180337/LCR-Analyzer-WebSite-ZXY/docs/show/html-to-ppt/assets/hw/ui-menu.jpg

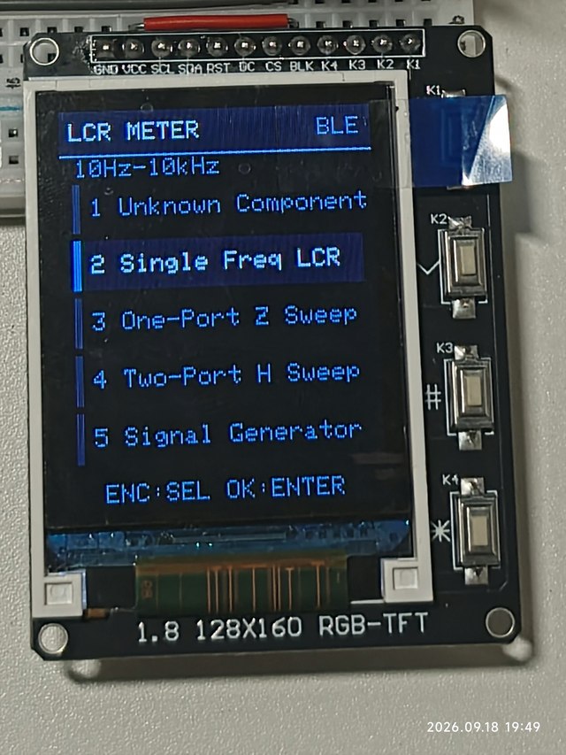
docs/show/html-to-ppt/assets/hw/ui-menu.jpg
