180337/LCR-Analyzer-WebSite-ZXY/docs/show/html-to-ppt/01-张行言-2025010170-硬设PPTv1.0.pptx

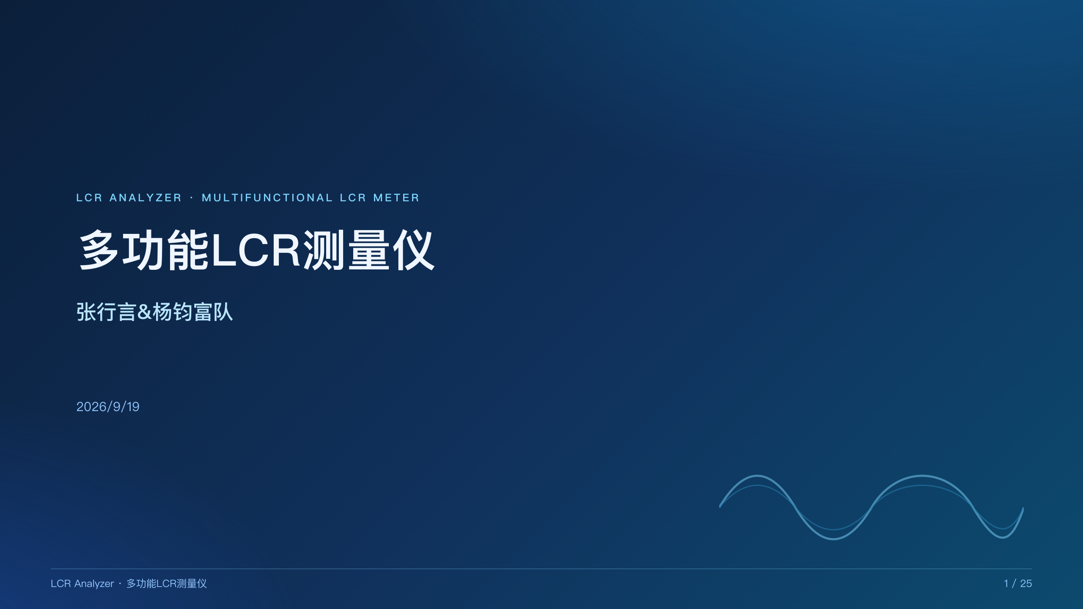
[picture p3: figure]

## Slide 2

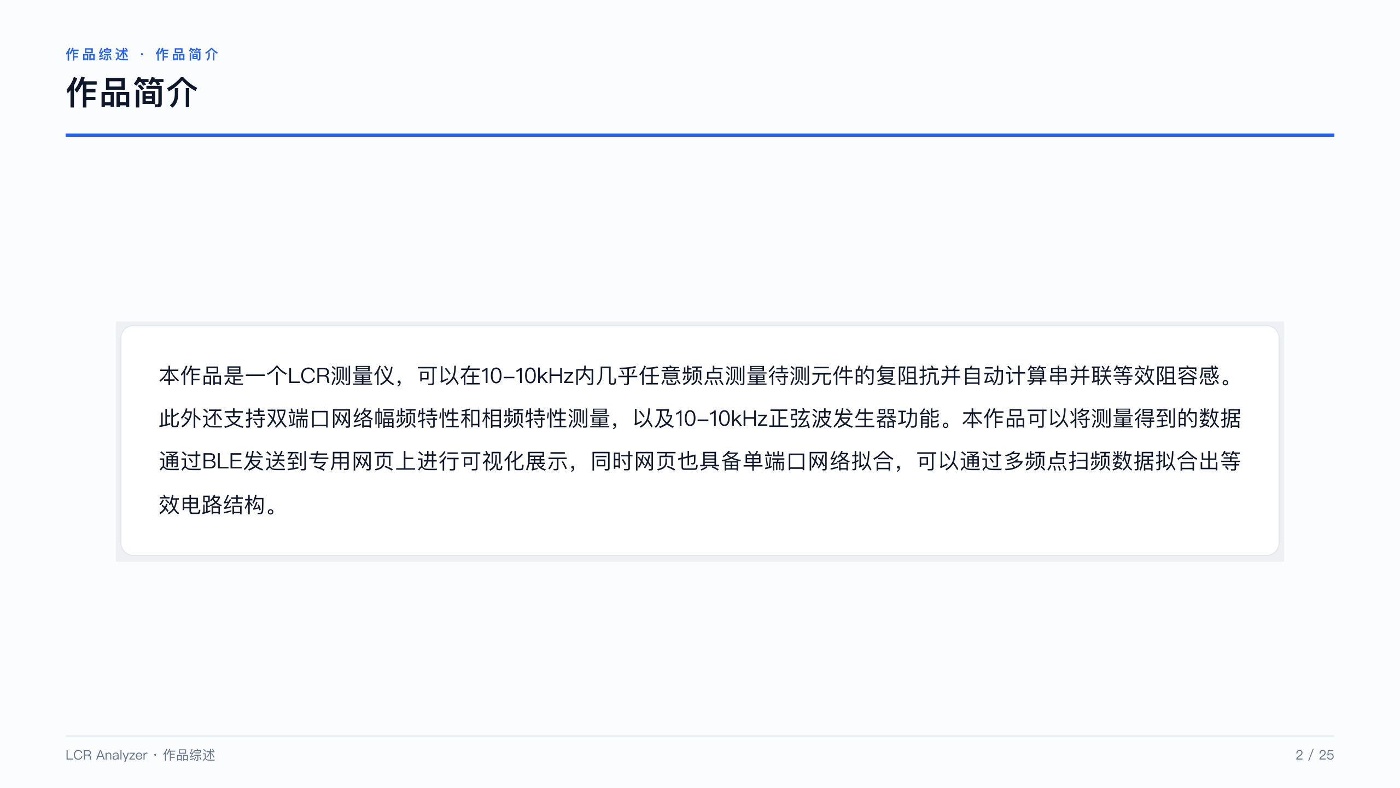
[picture p4: figure]

## Slide 3

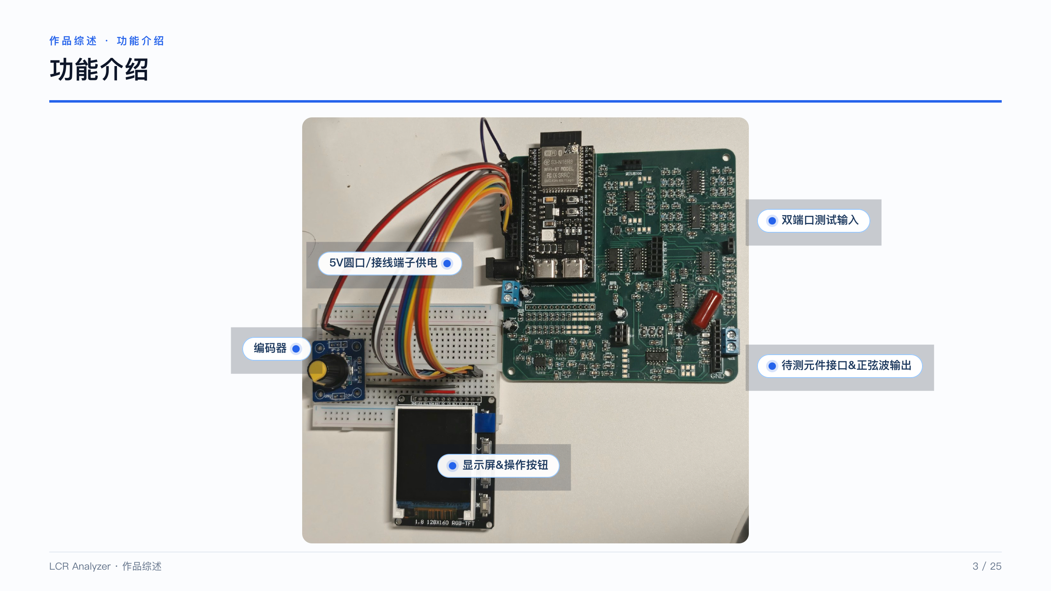
[picture p5: figure]

## Slide 4

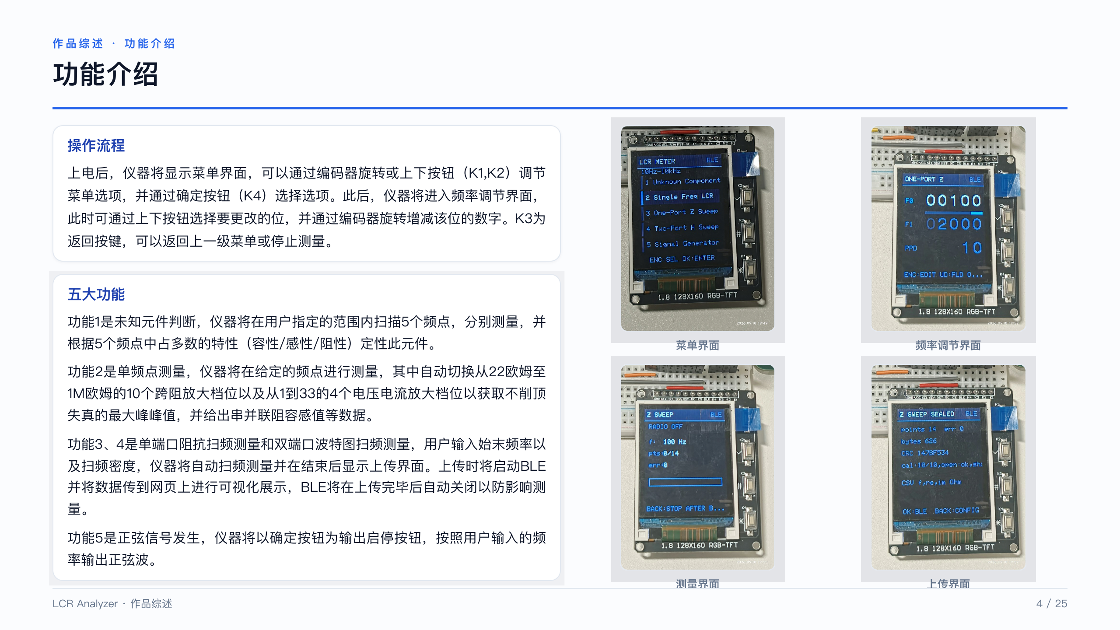
[picture p6: figure]

## Slide 5

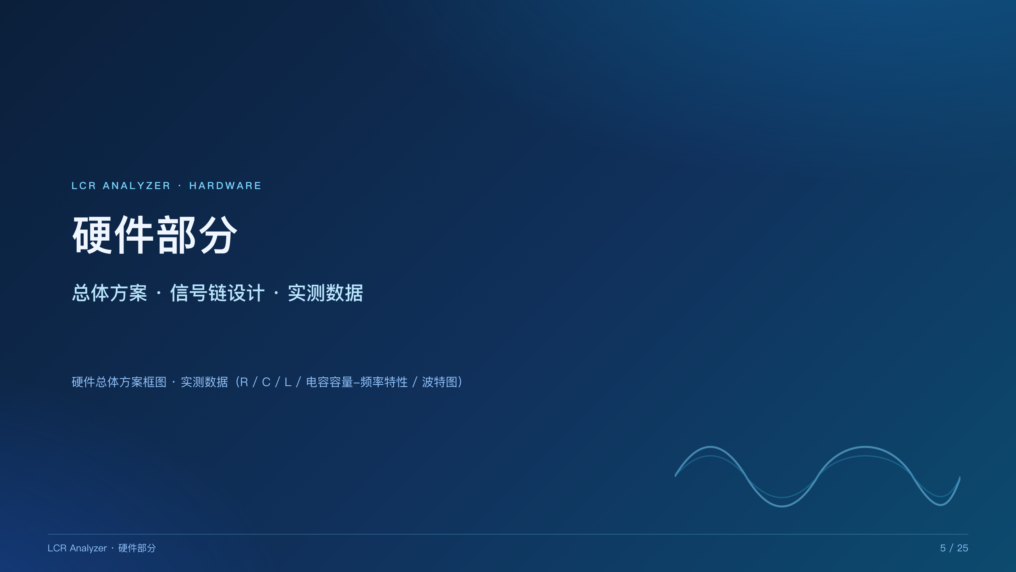
[picture p7: figure]

## Slide 6

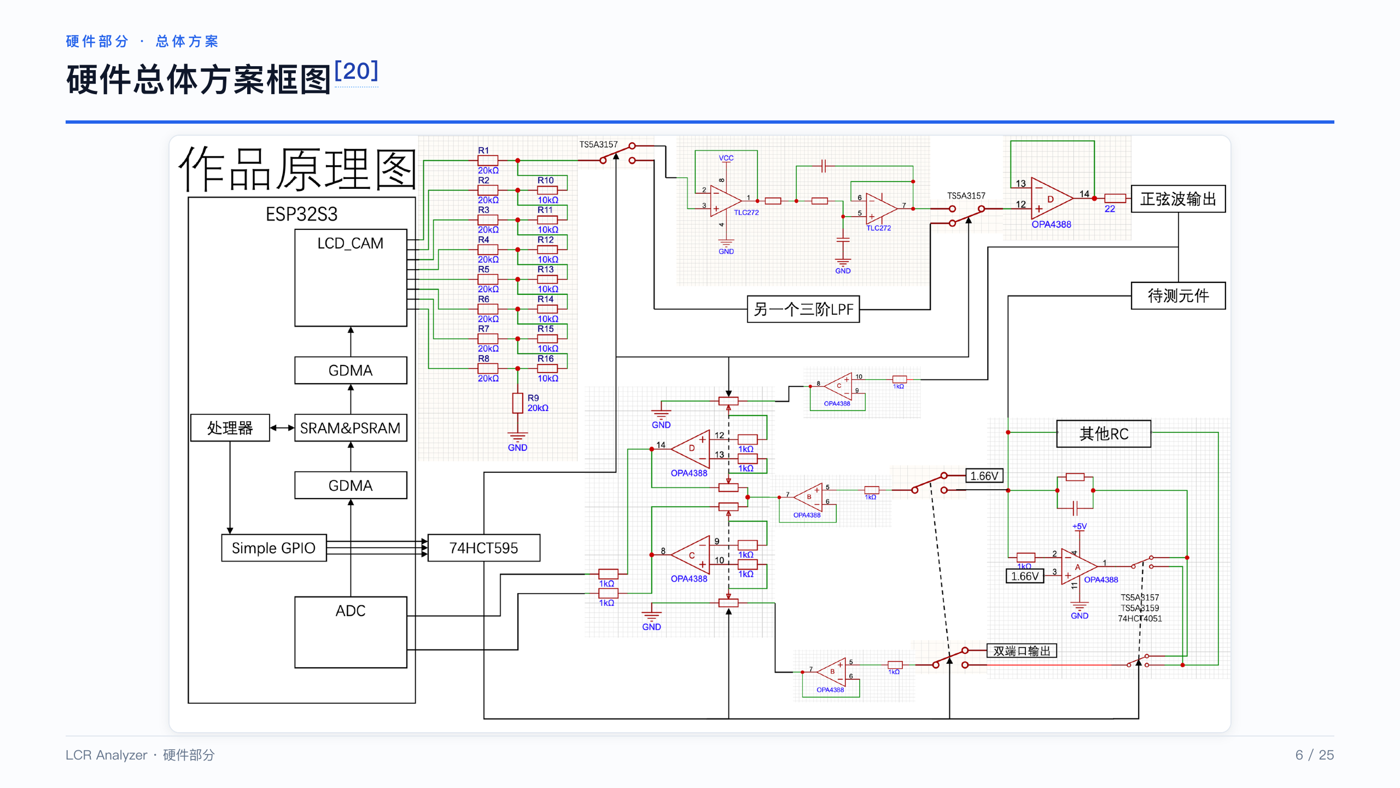
[picture p8: figure]

## Slide 7

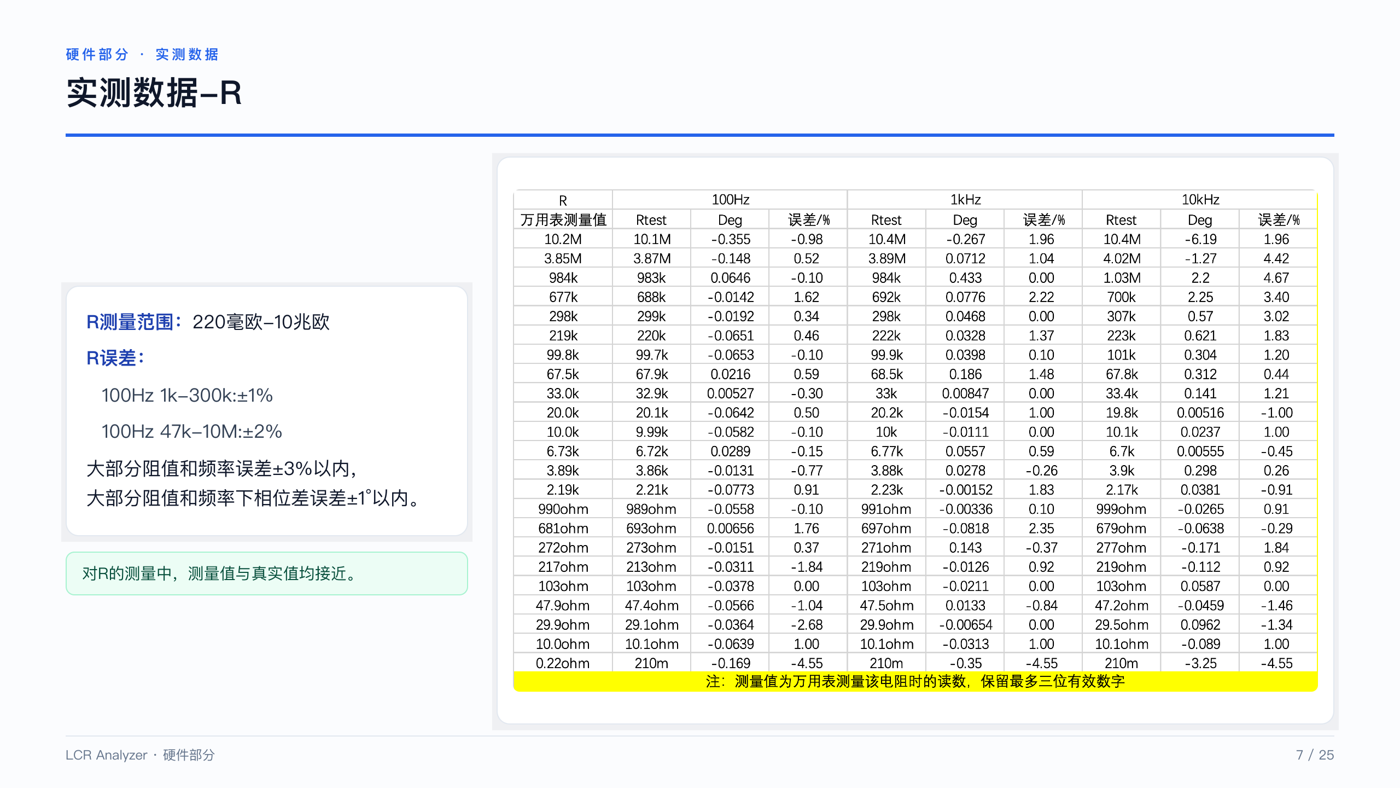
[picture p9: figure]

## Slide 8

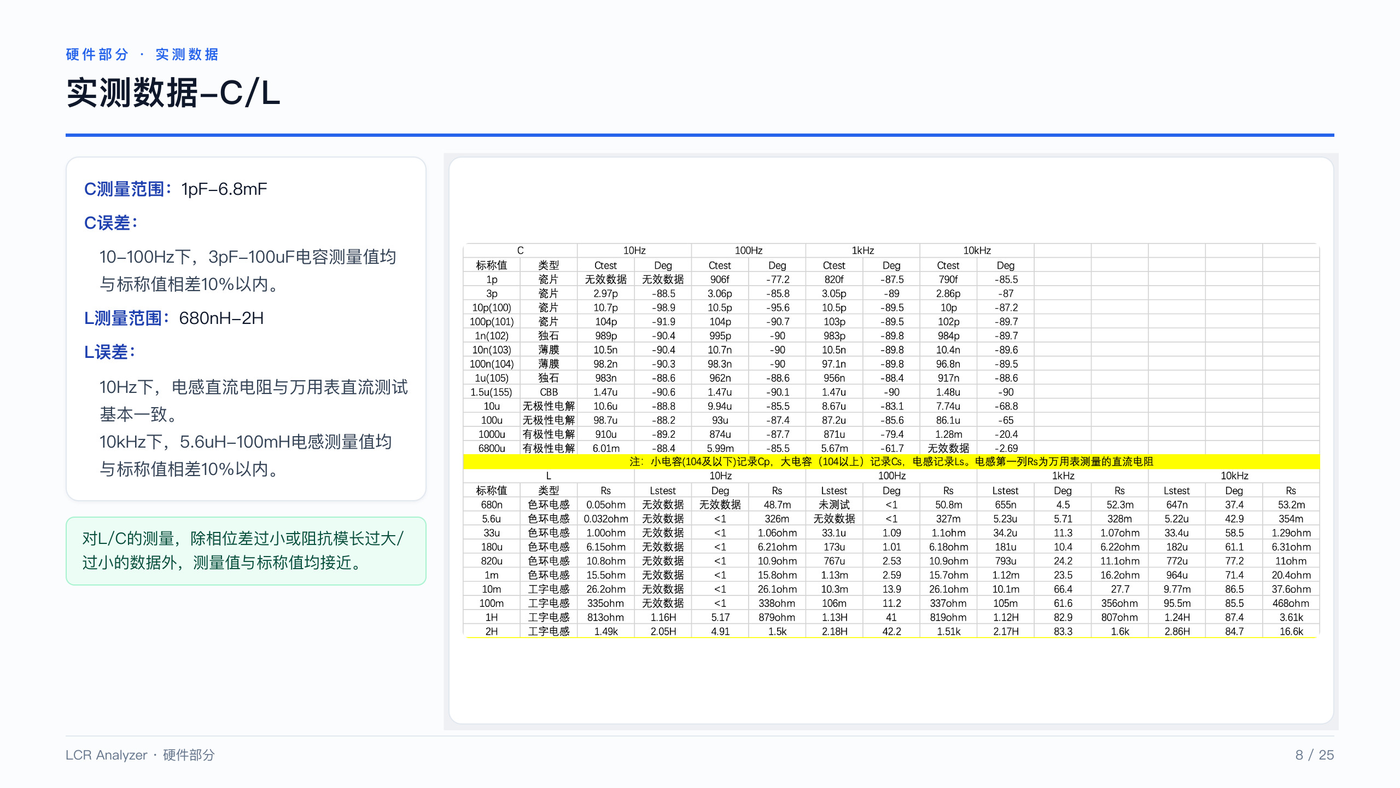
[picture p10: figure]

## Slide 9

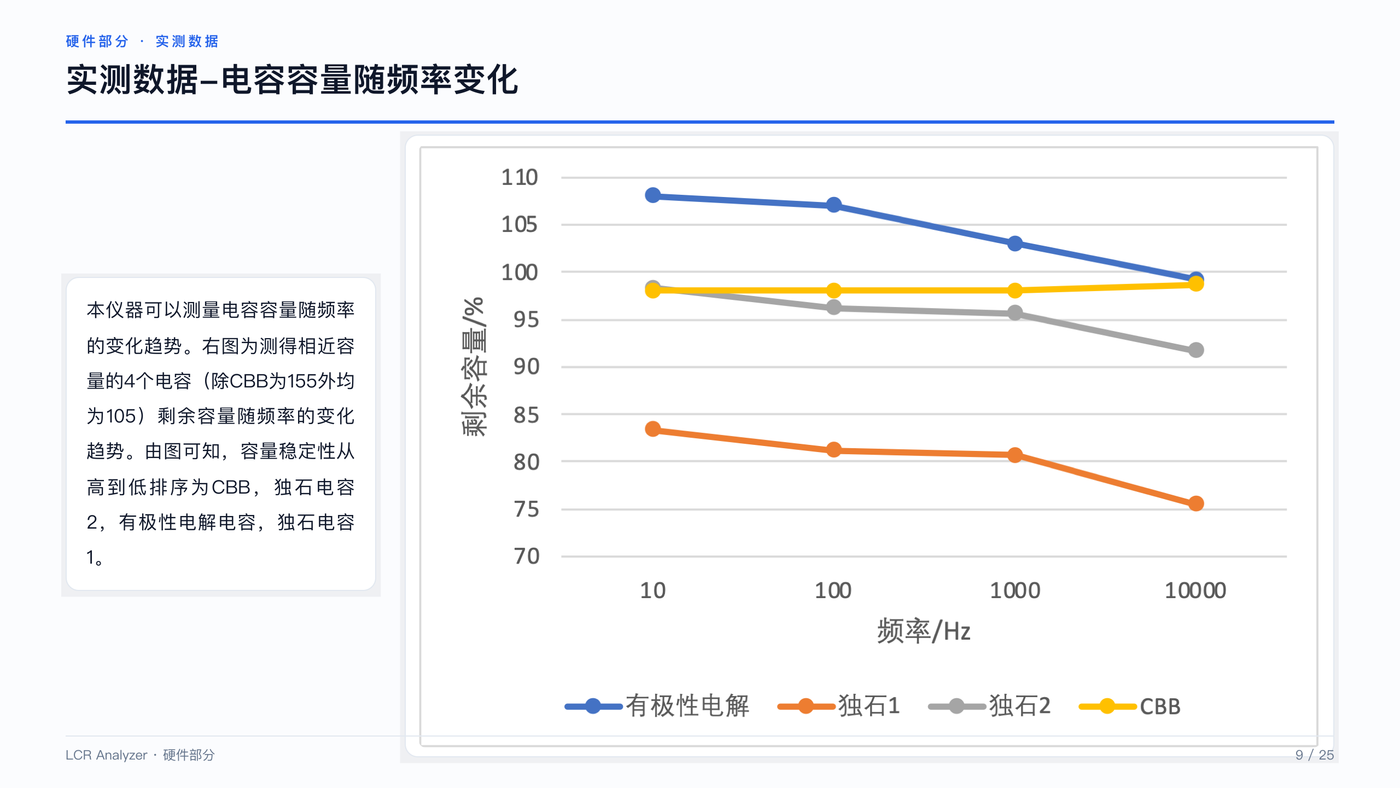
[picture p11: figure]

## Slide 10

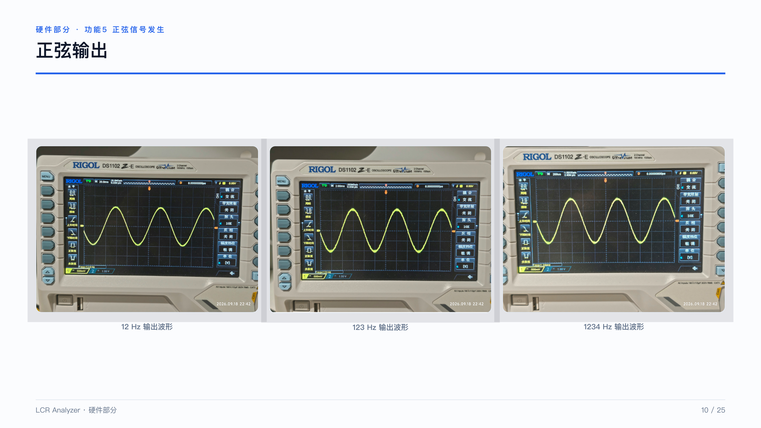
[picture p12: figure]

## Slide 11

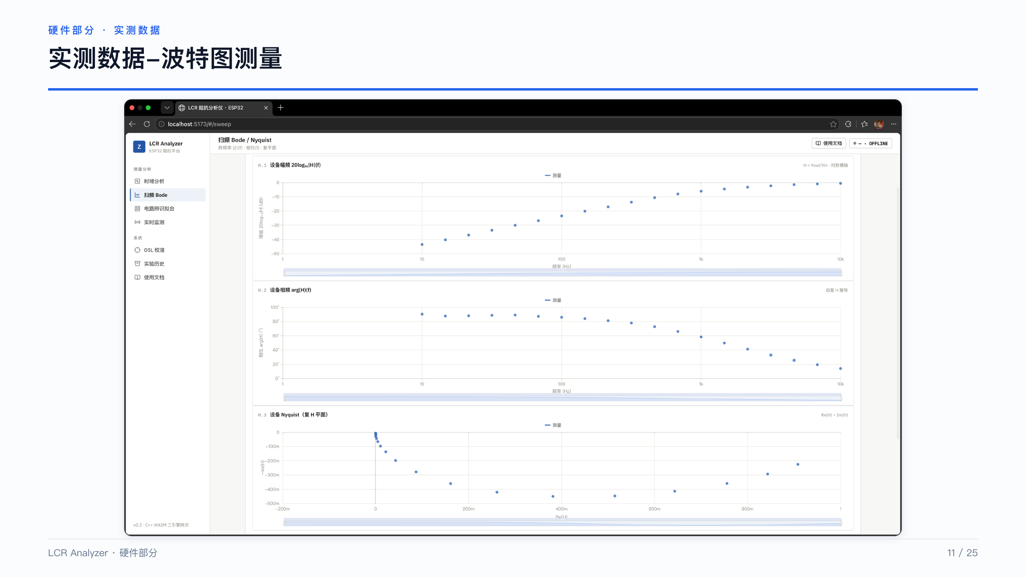
[picture p13: figure]

## Slide 12

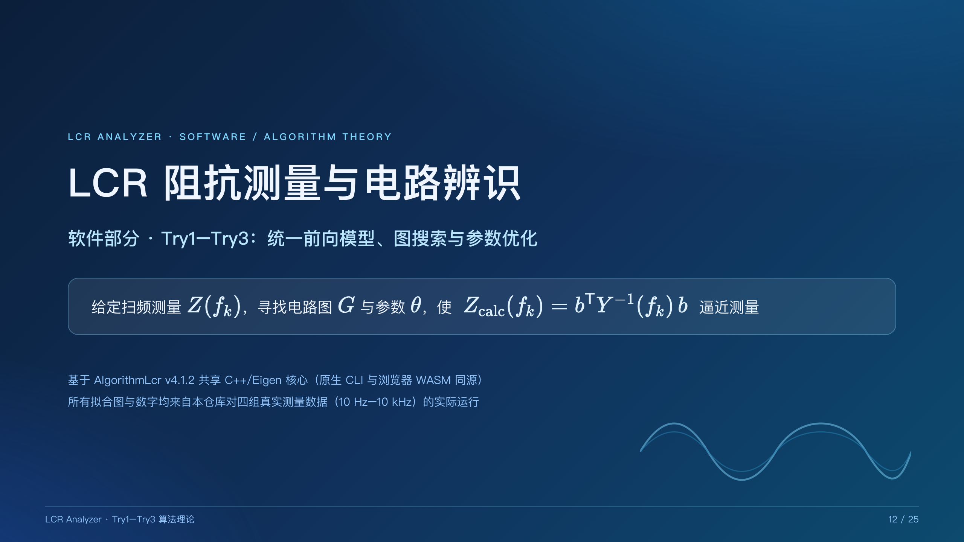
[picture p14: figure]

## Slide 13

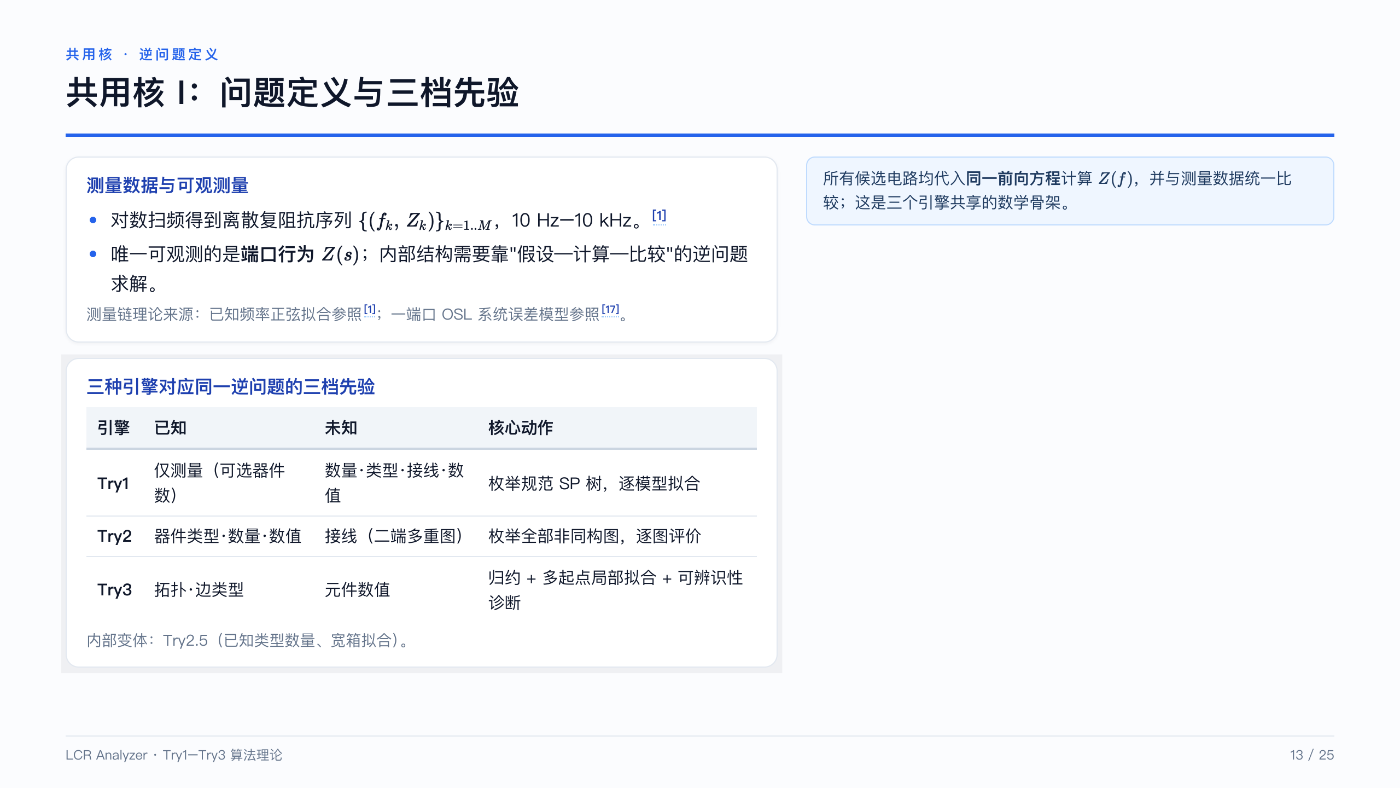
[picture p15: figure]

## Slide 14

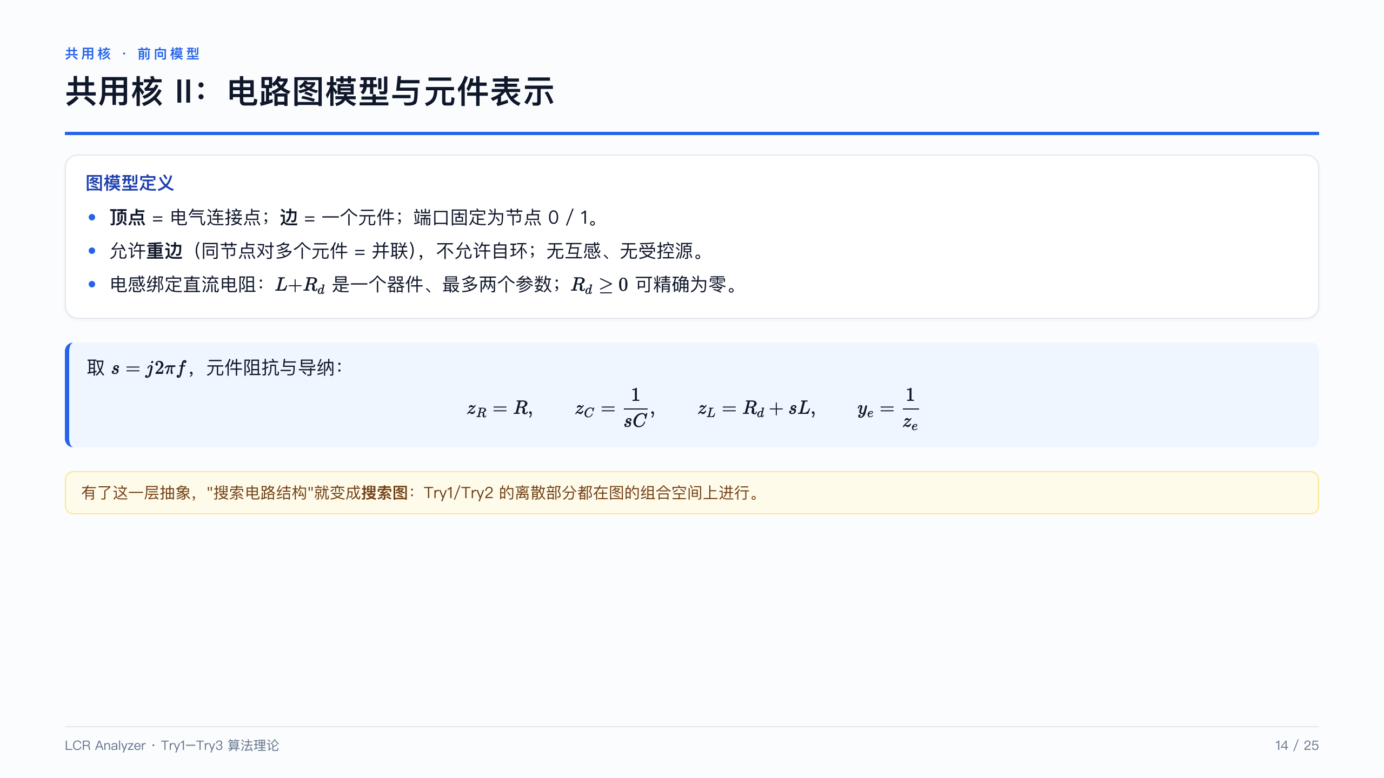
[picture p16: figure]

## Slide 15

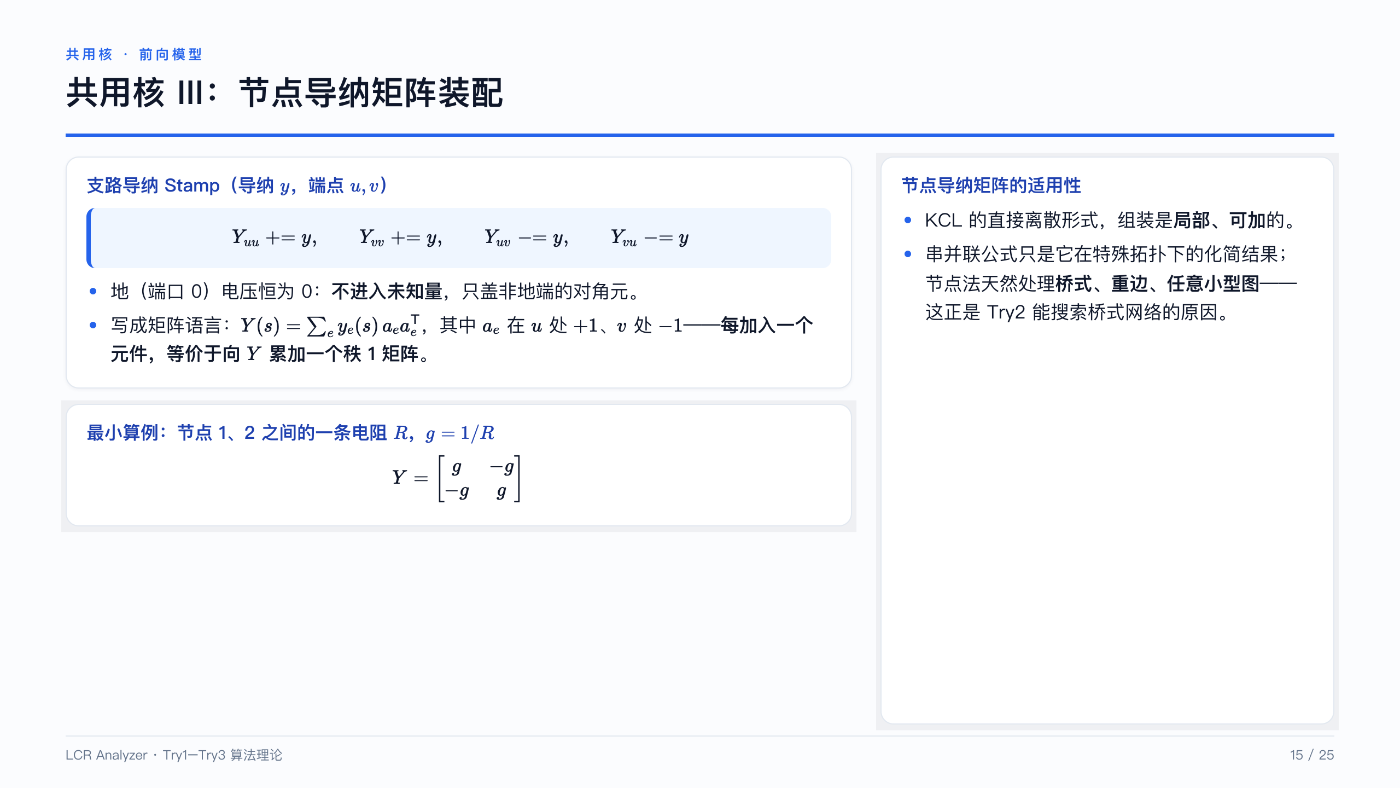
[picture p17: figure]

## Slide 16

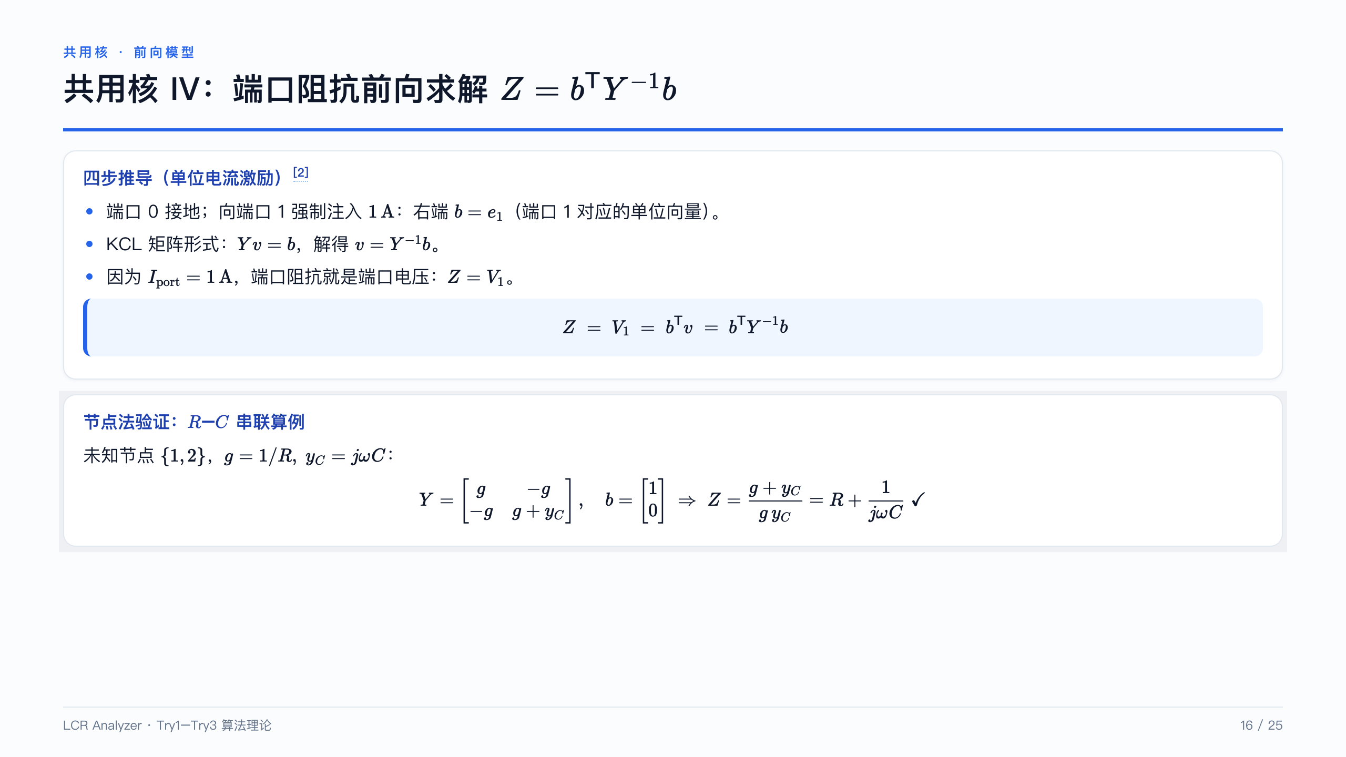
[picture p18: figure]

## Slide 17

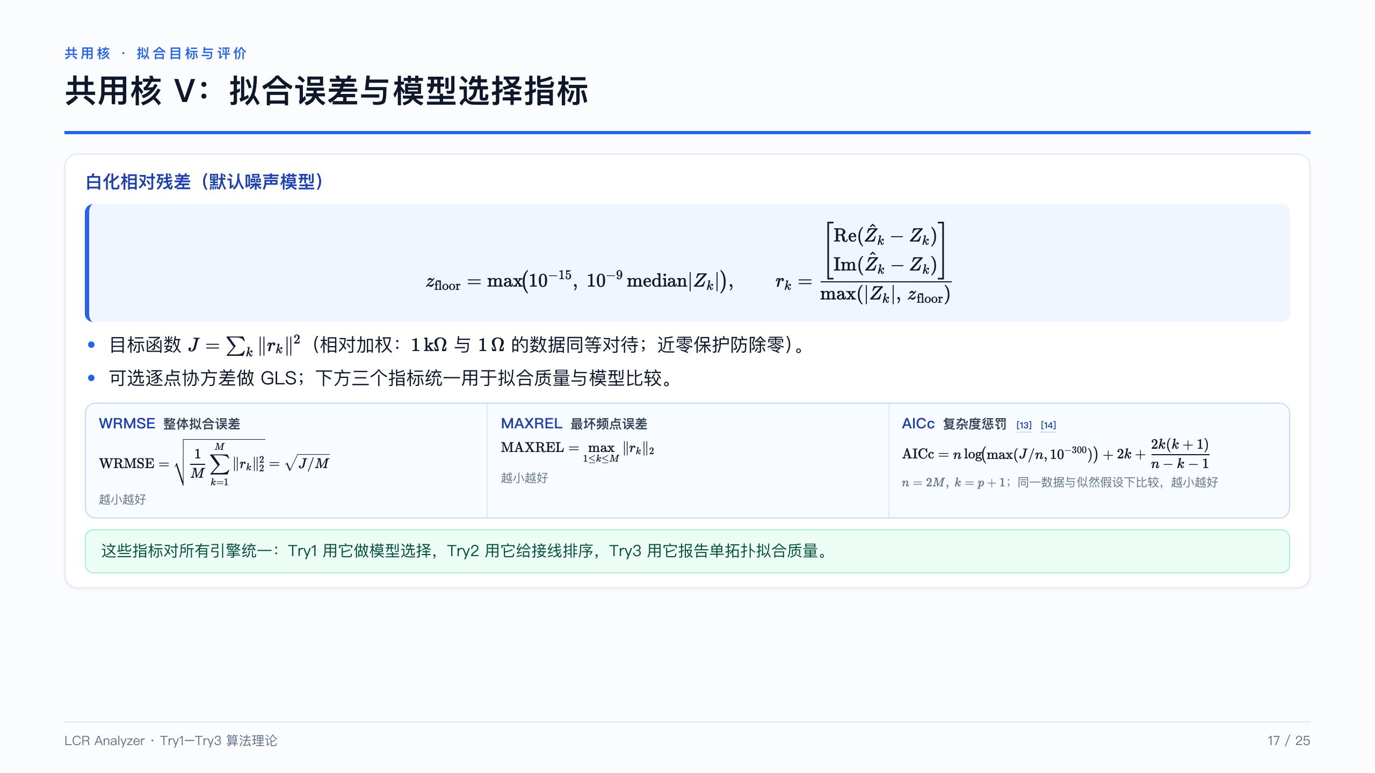
[picture p19: figure]

## Slide 18

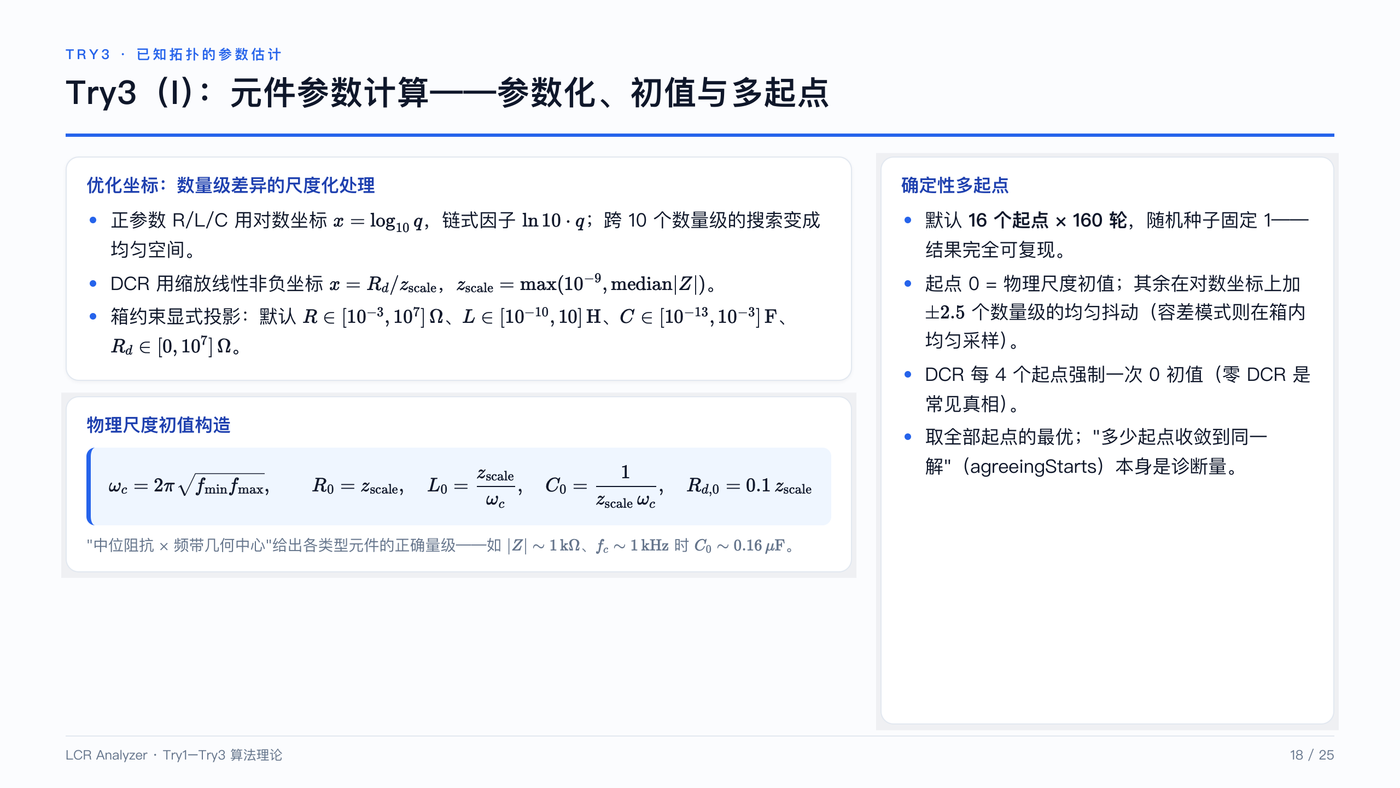
[picture p20: figure]

## Slide 19

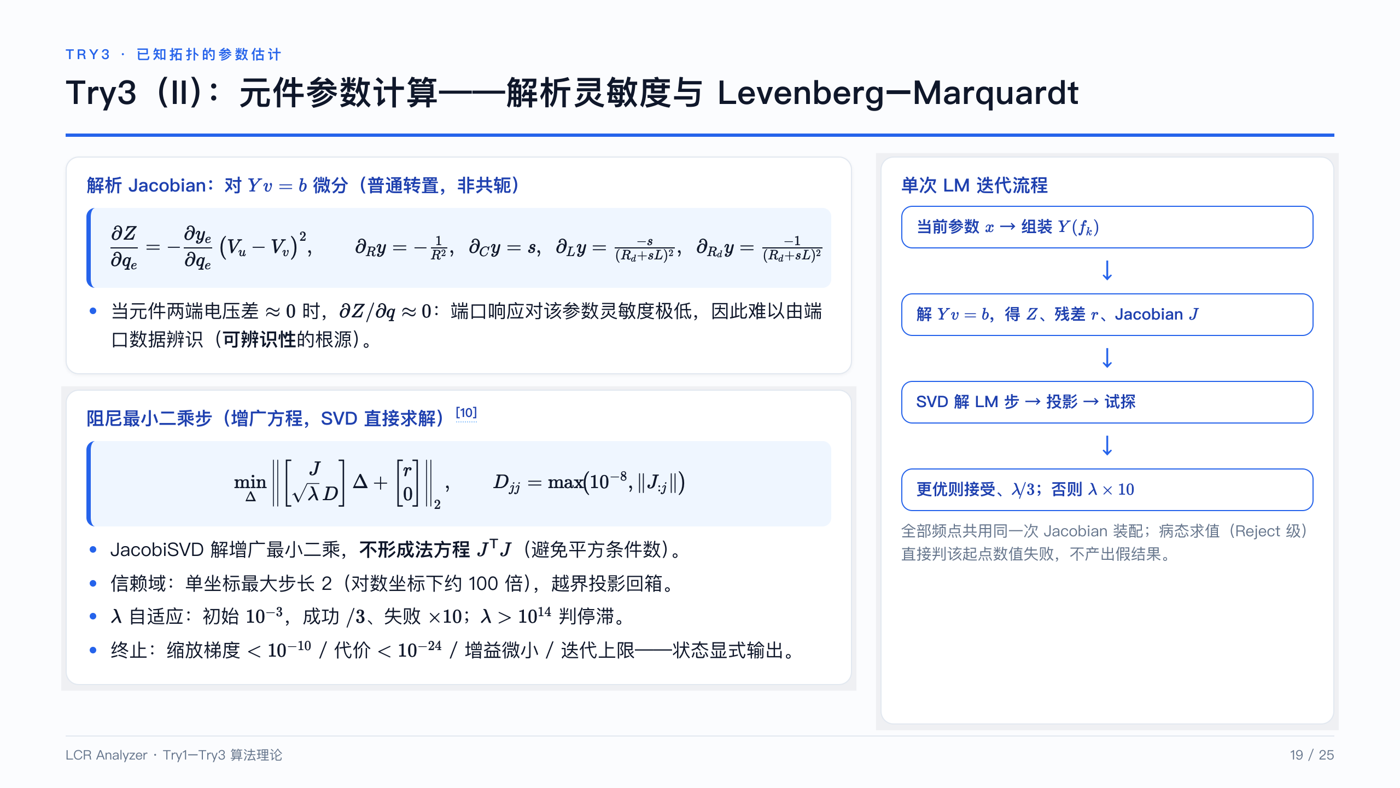
[picture p21: figure]

## Slide 20

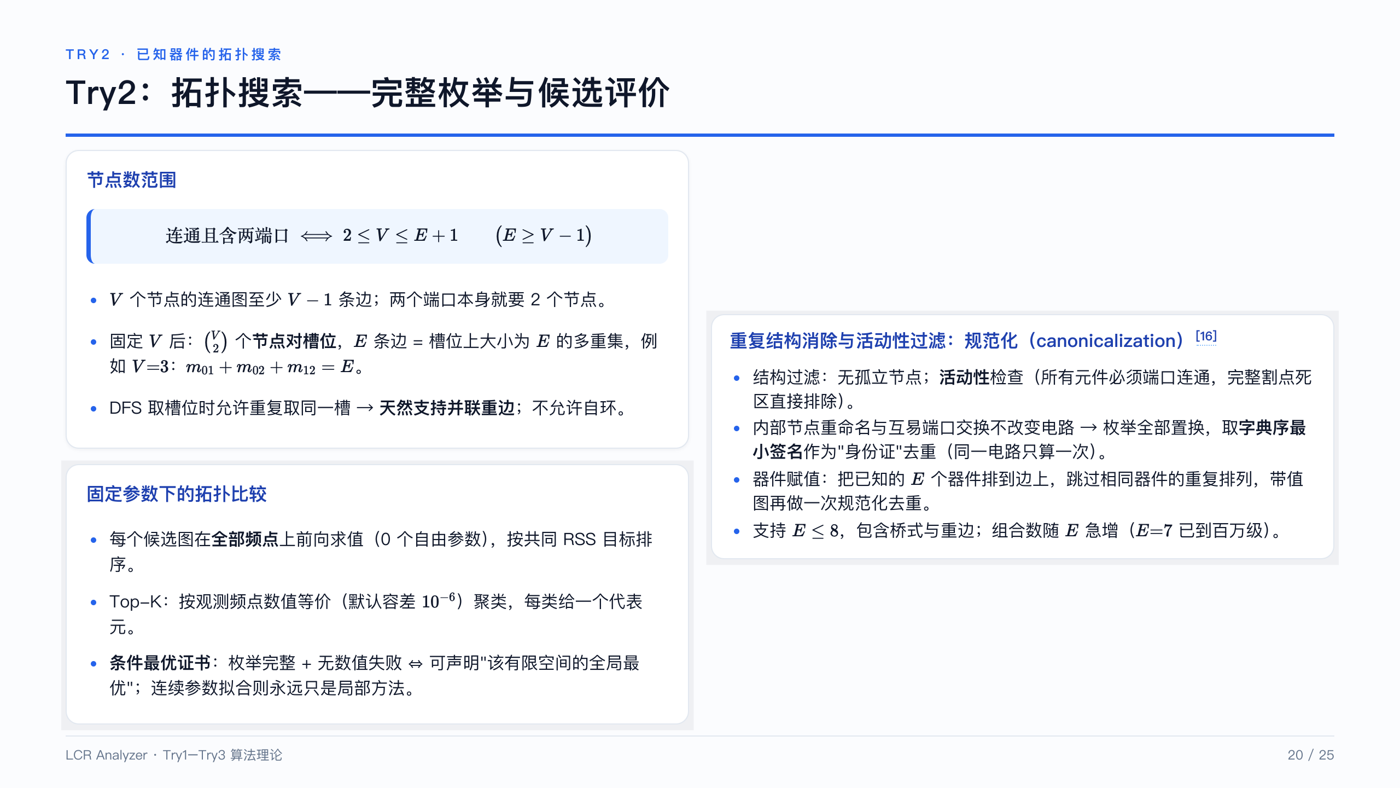
[picture p22: figure]

## Slide 21

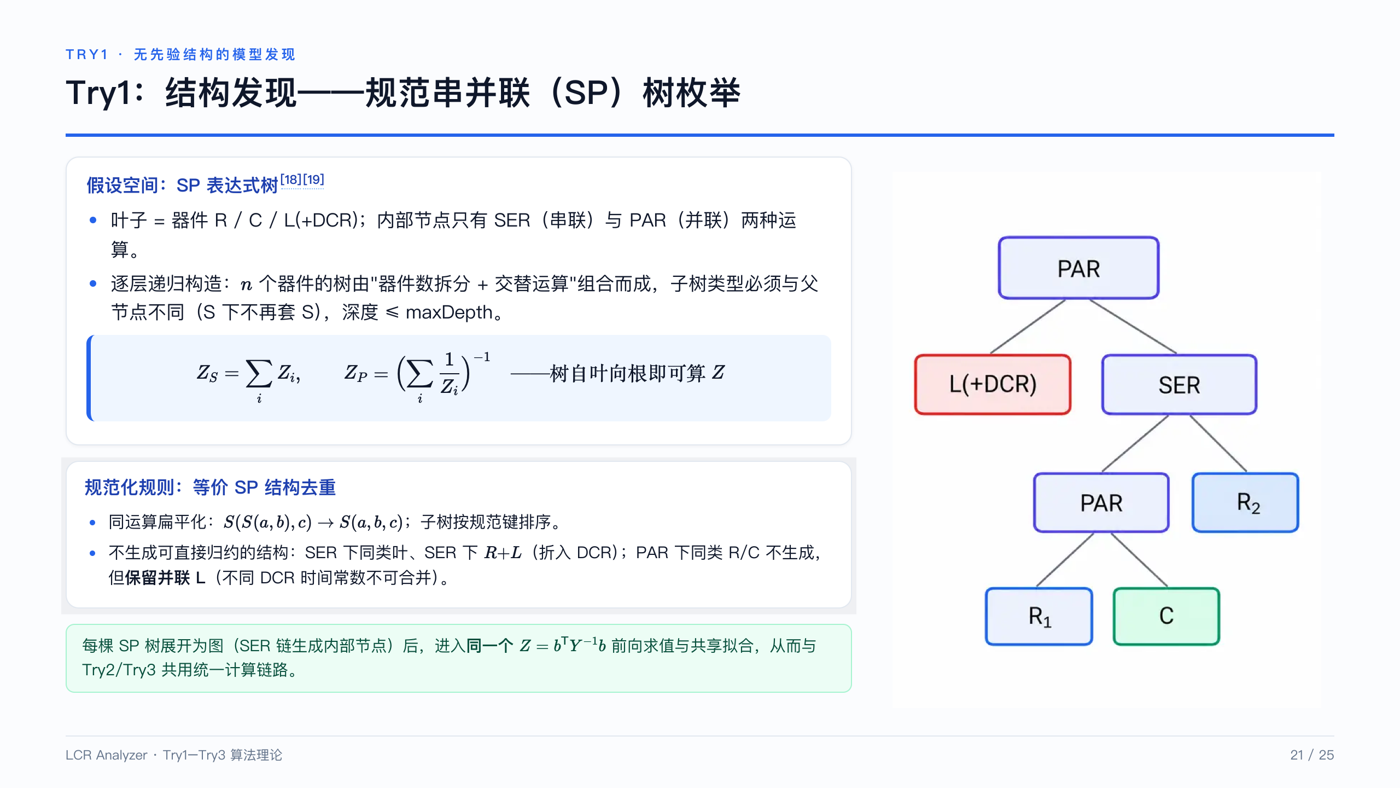
[picture p23: figure]

## Slide 22

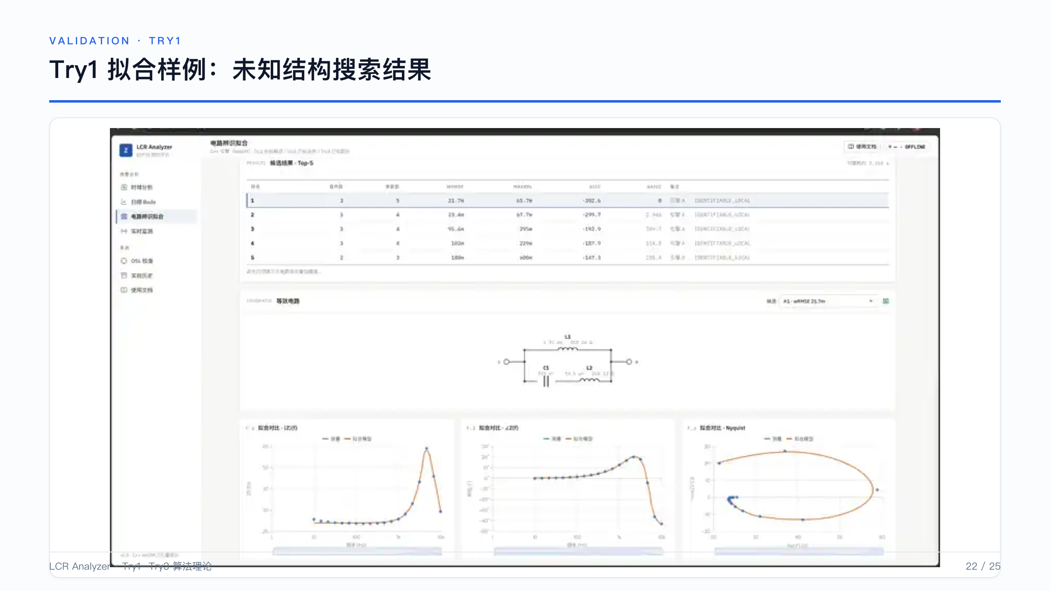
[picture p24: figure]

## Slide 23

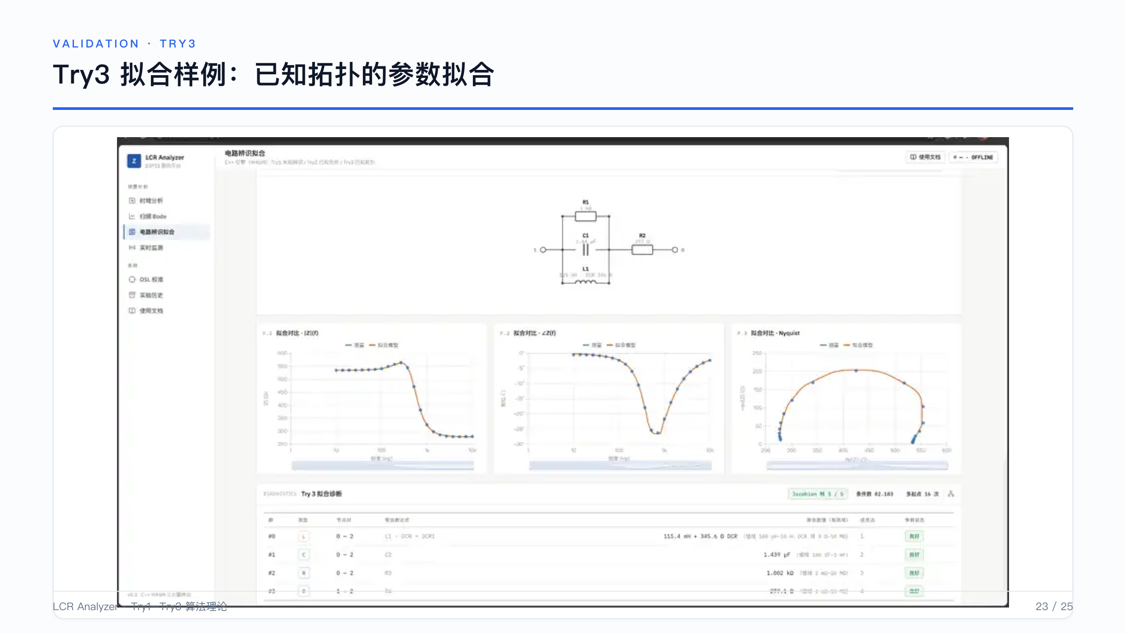
[picture p25: figure]

## Slide 24

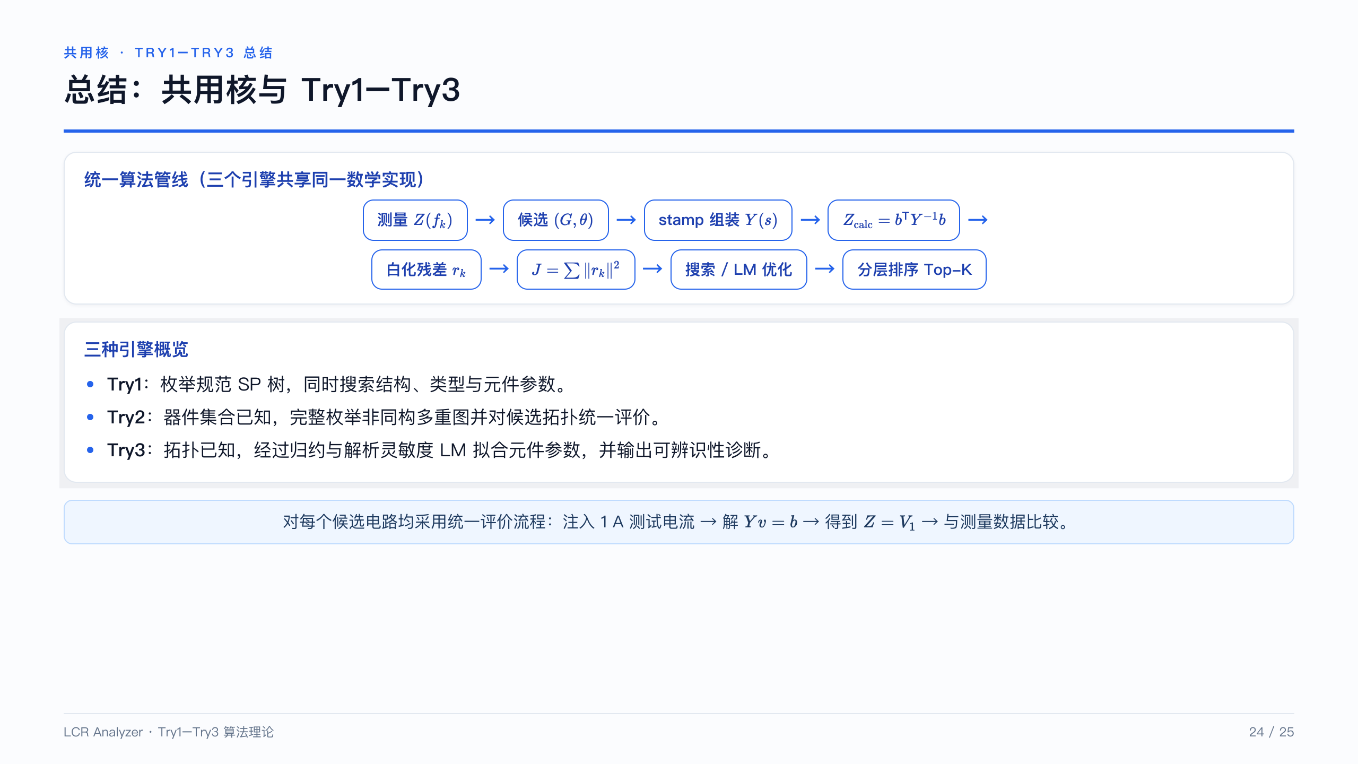
[picture p26: figure]

## Slide 25

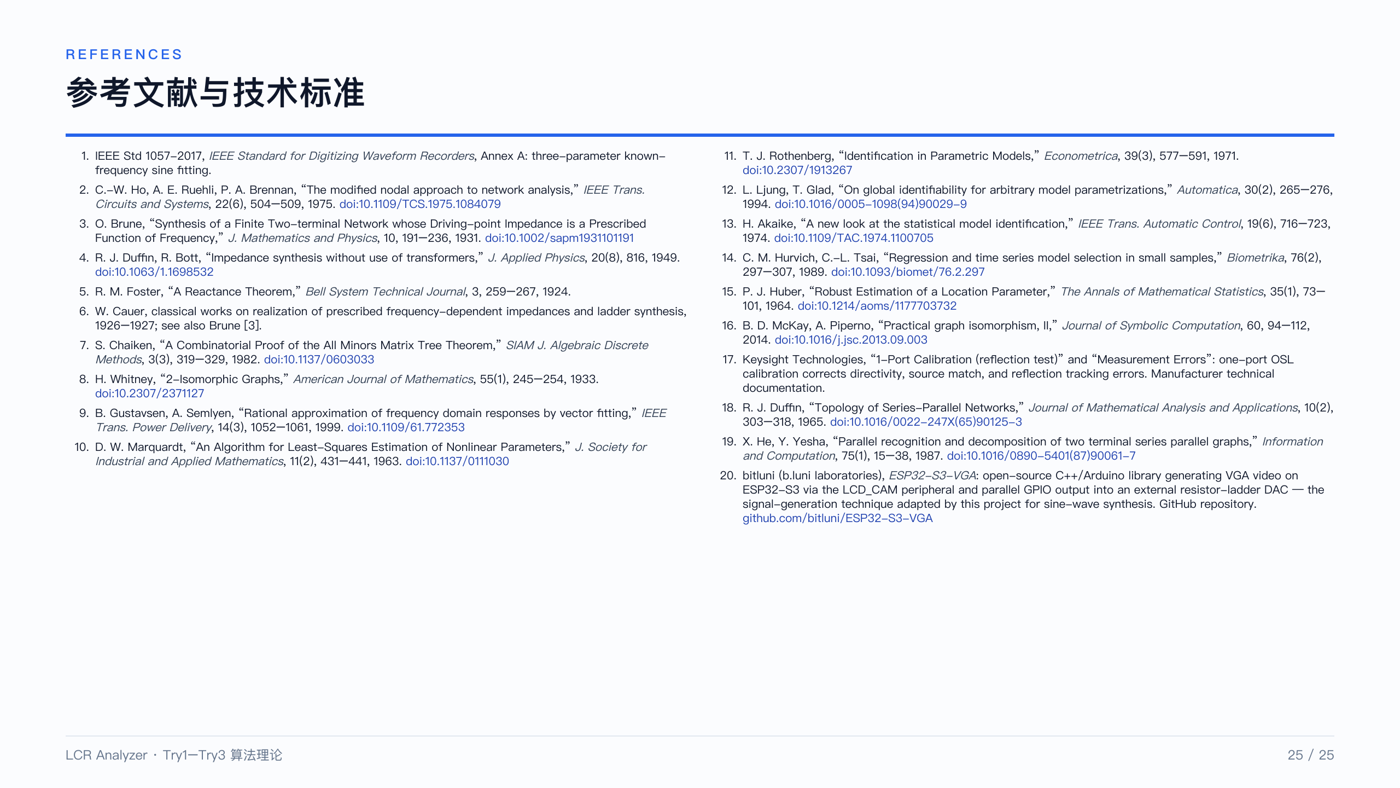
[picture p27: figure]
