180337/LCR-Analyzer-WebSite-ZXY/docs/show/html-to-ppt/assets/figs/fig-funnel.png

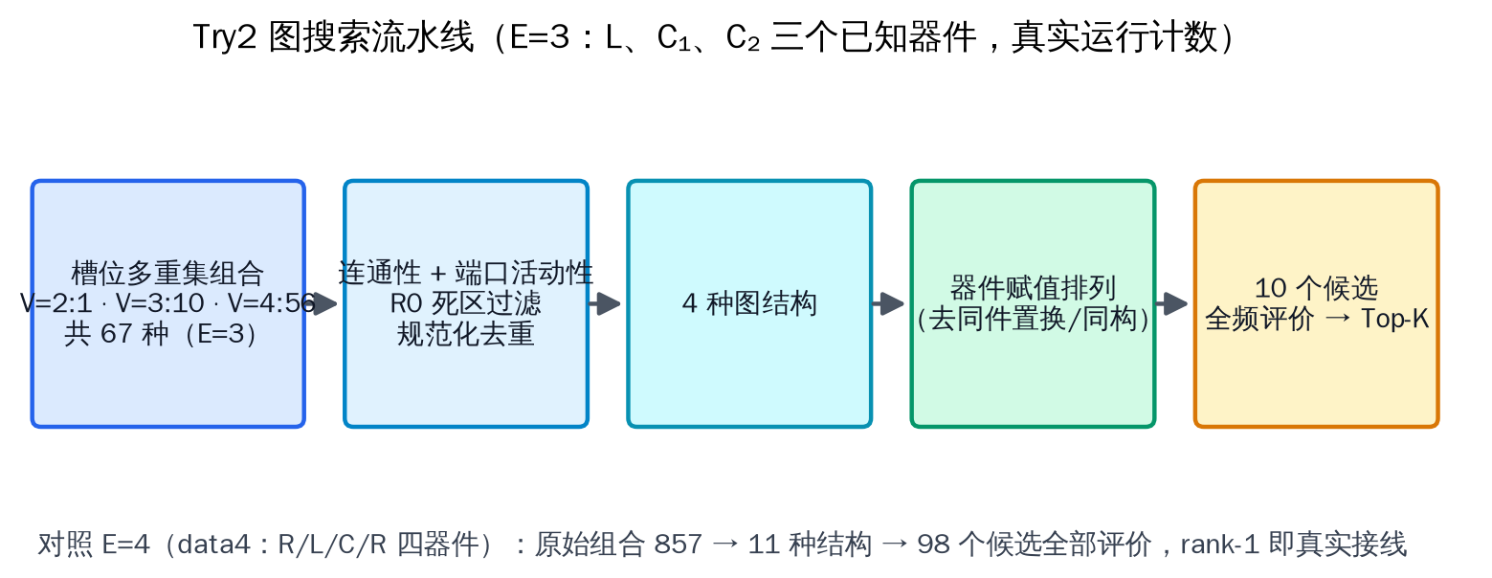
docs/show/html-to-ppt/assets/figs/fig-funnel.png
