180337/LCR-Analyzer-WebSite-ZXY/docs/show/html-to-ppt/assets/figs/try1-data2-2.png

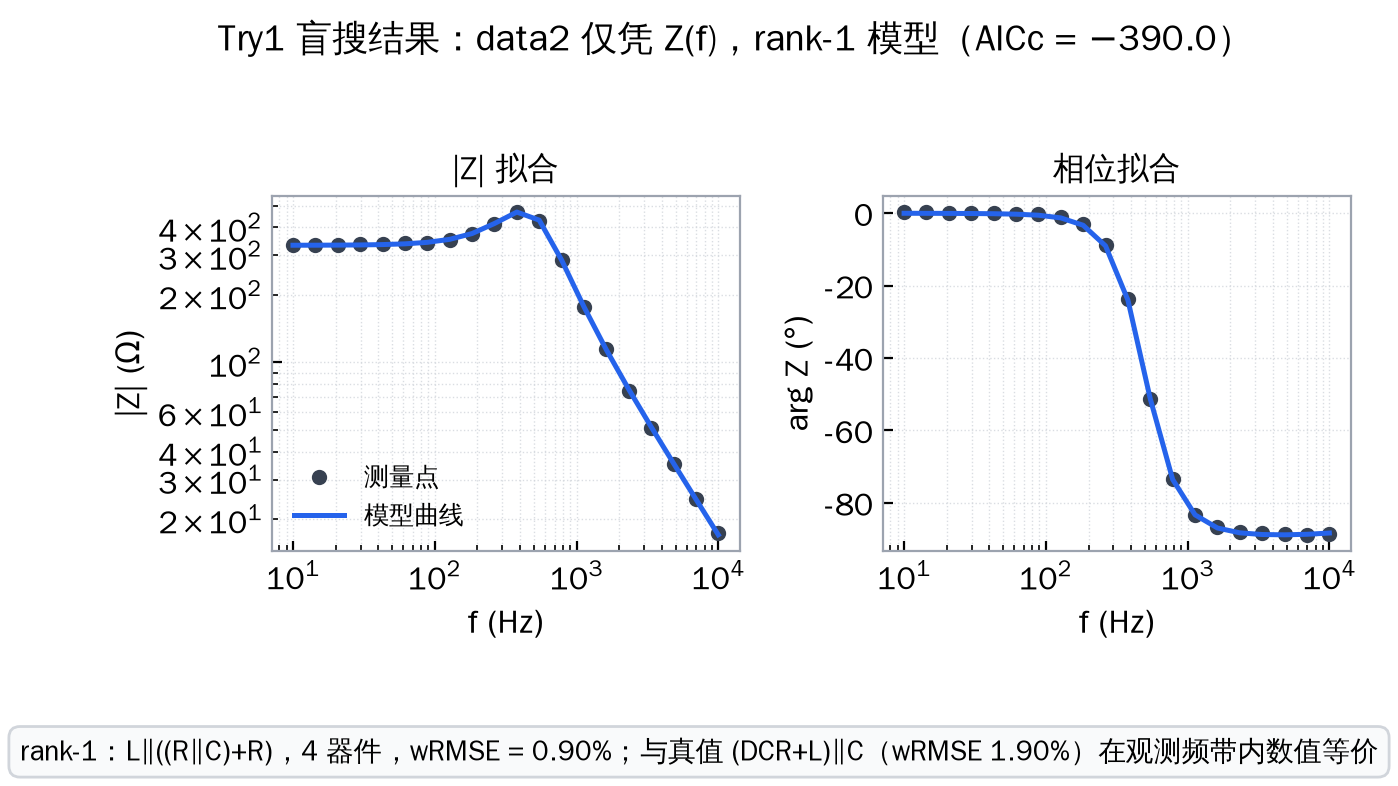
docs/show/html-to-ppt/assets/figs/try1-data2-2.png
