180337/LCR-Analyzer-WebSite-ZXY/docs/show/html-to-ppt/assets/figs/try3-data3-3.png

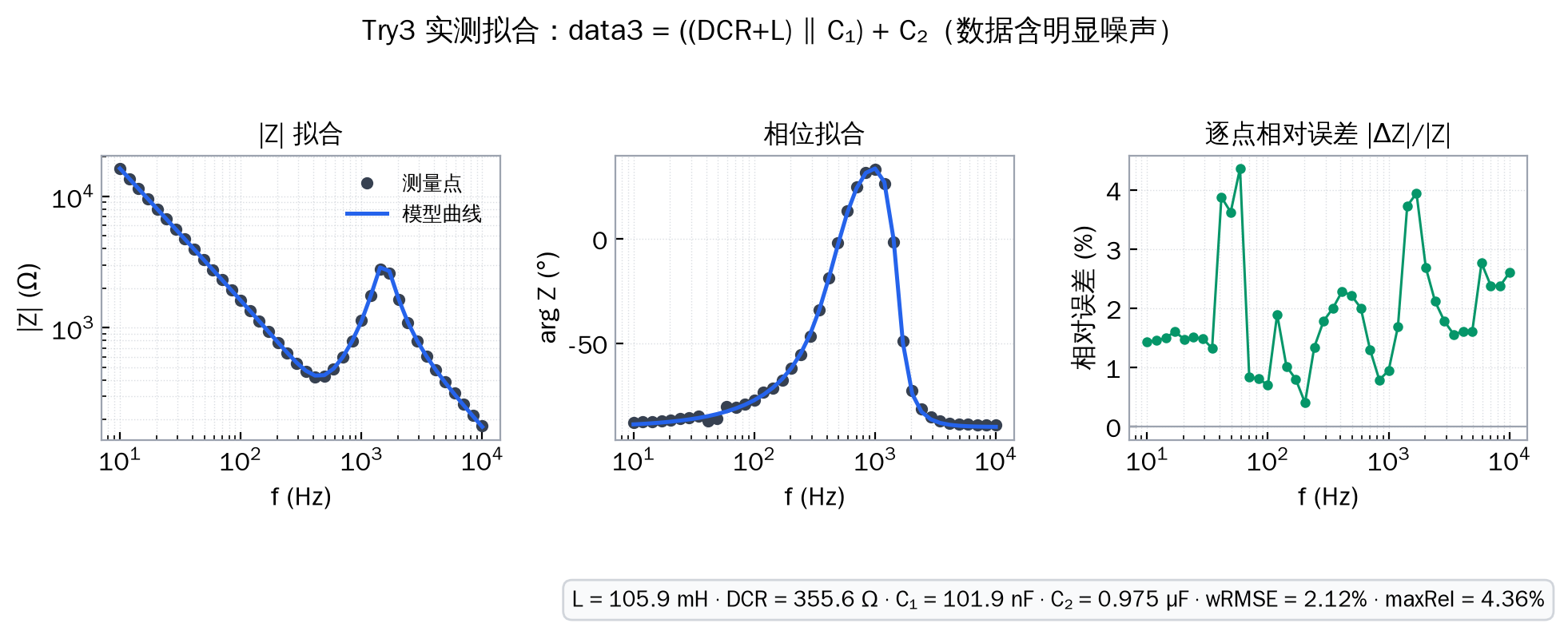
docs/show/html-to-ppt/assets/figs/try3-data3-3.png
