180337/LCR-Analyzer-WebSite-ZXY/docs/show/html-to-ppt/assets/figs/try3-data4-4.png

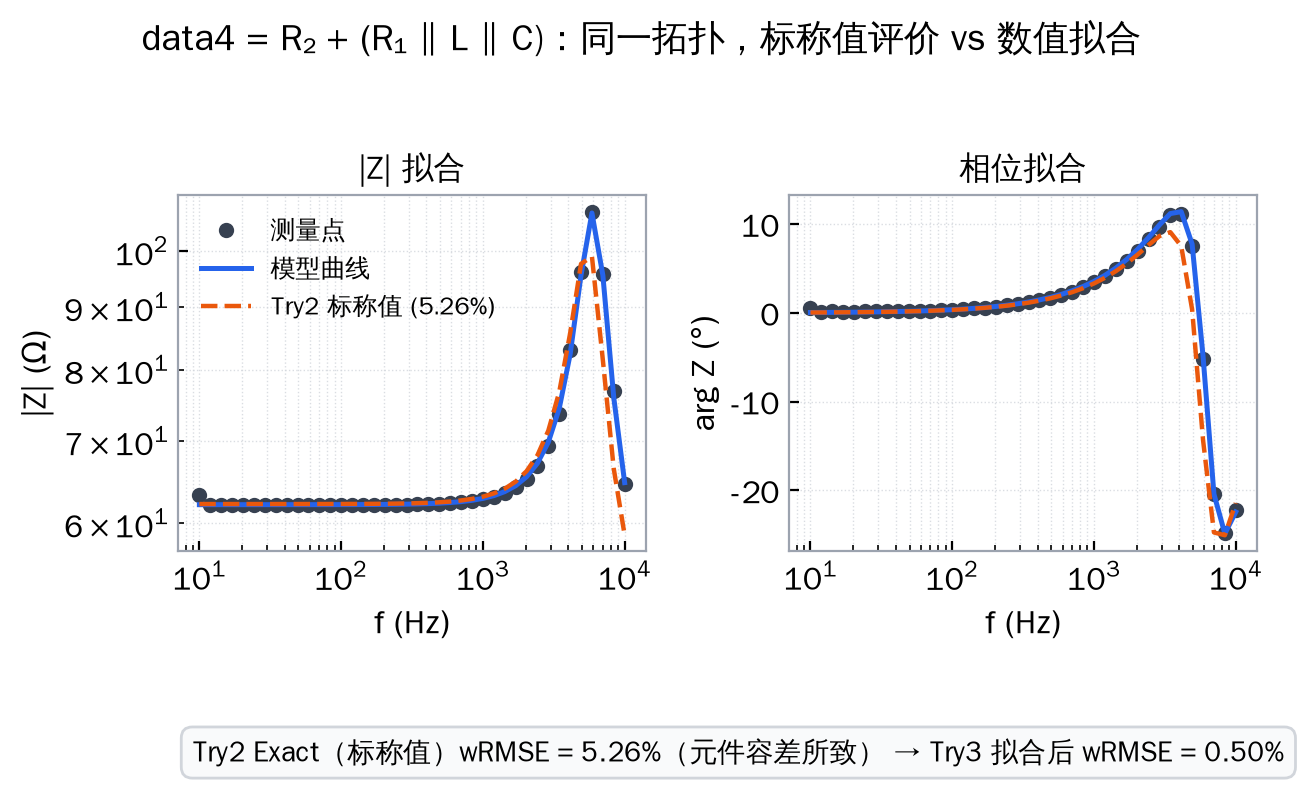
docs/show/html-to-ppt/assets/figs/try3-data4-4.png
