180337/LCR-Analyzer-WebSite-ZXY/docs/show/html-to-ppt/assets/hw/bode.png

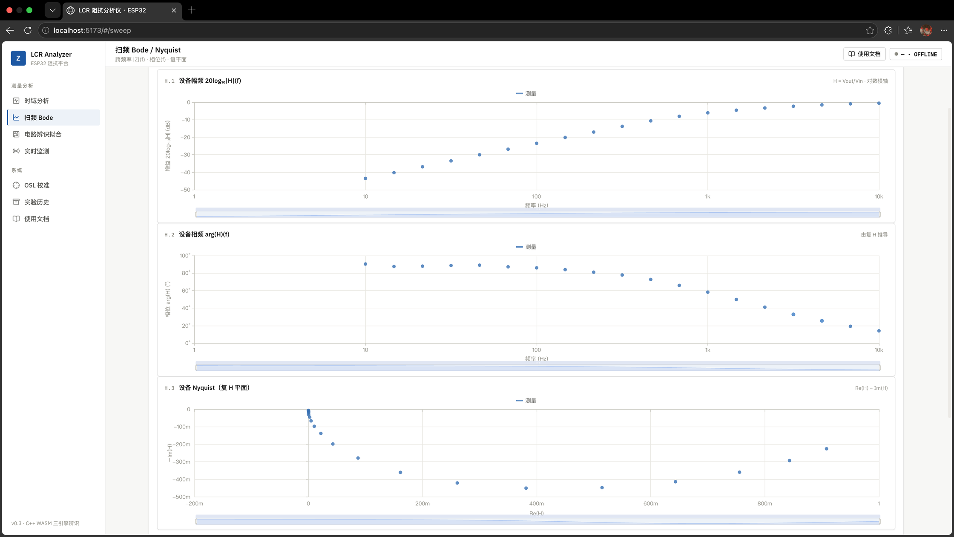
docs/show/html-to-ppt/assets/hw/bode.png
