180337/LCR-Analyzer-WebSite-ZXY/docs/show/html-to-ppt/assets/hw/data-cfreq.png

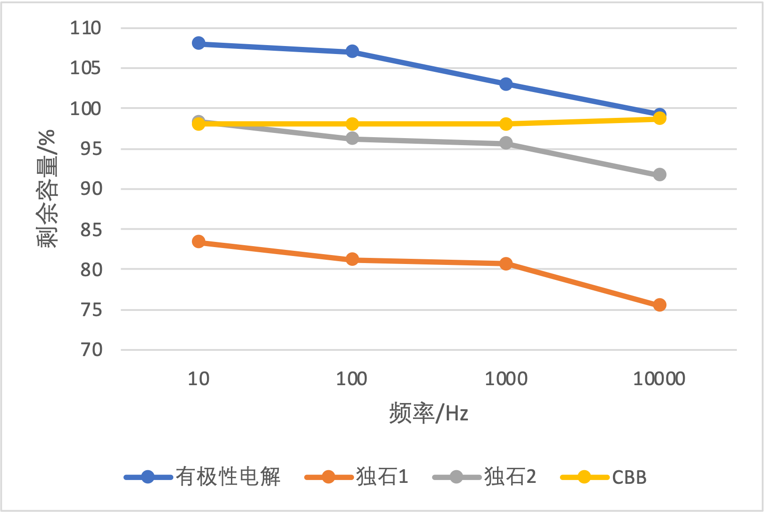
docs/show/html-to-ppt/assets/hw/data-cfreq.png
