180337/LCR-Analyzer-WebSite-ZXY/docs/show/html-to-ppt/assets/hw/sine-12hz.jpg

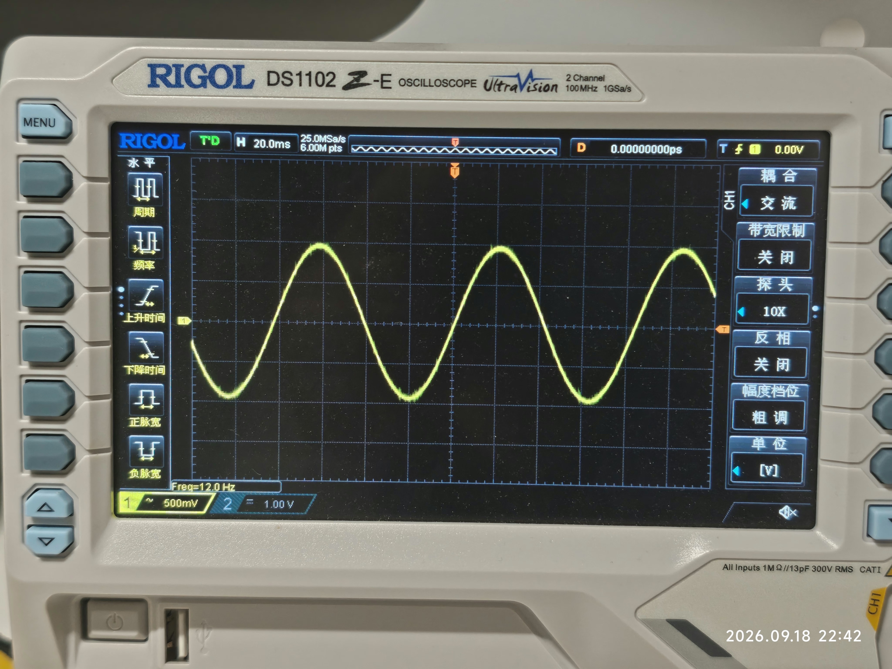
docs/show/html-to-ppt/assets/hw/sine-12hz.jpg
