180337/LCR-Analyzer-WebSite-ZXY/docs/show/html-to-ppt/LCR-硬件与Try1-Try3理论.pdf

L C R A N A L Y Z E R · M U L T I F U N C T I O N A L L C R M E T E R

# 多功能LCR测量仪

# 张行言&杨钧富队

2026/9/19

LCR Analyzer · 多功能LCR测量仪 | 1 / 25

作 品 综 述 · 作 品 简 介

# 作品简介

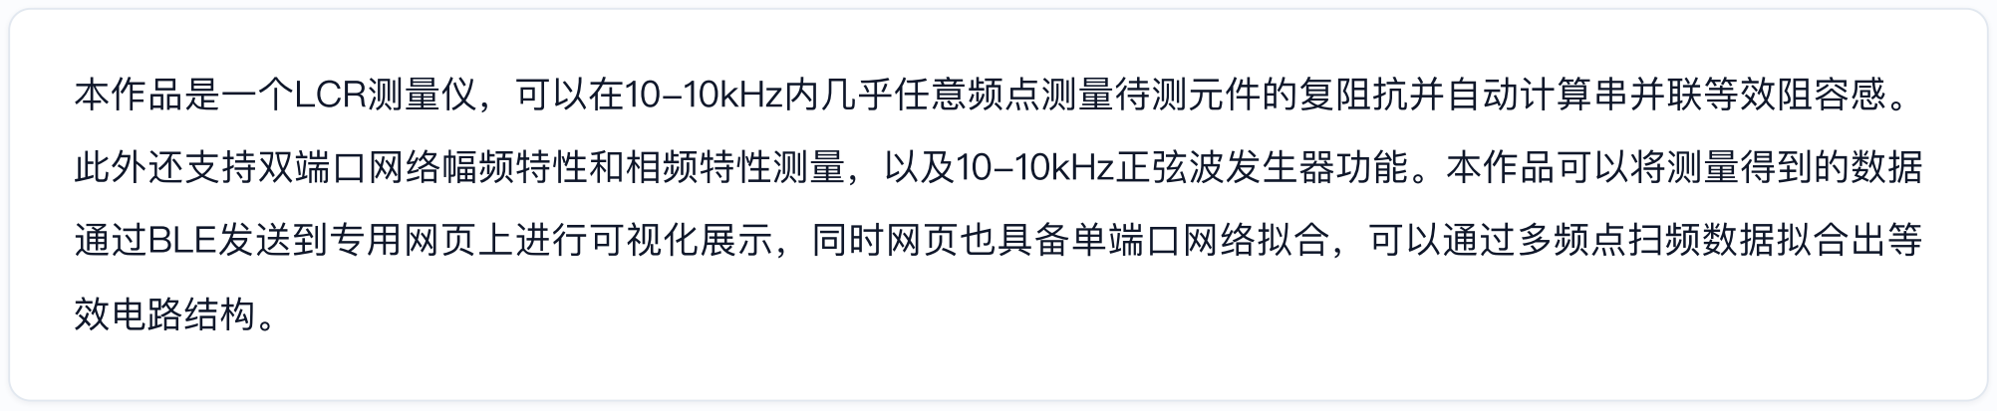
[picture p51: figure]
效电路结构。

## 本作品是一个LCR测量仪，可以在10-10kHz内几乎任意频点测量待测元件的复阻抗并自动计算串并联等效阻容感。

## 此外还支持双端口网络幅频特性和相频特性测量，以及10-10kHz正弦波发生器功能。本作品可以将测量得到的数据

## 通过BLE发送到专用网页上进行可视化展示，同时网页也具备单端口网络拟合，可以通过多频点扫频数据拟合出等

LCR Analyzer · 作品综述 | 2 / 25

# 功能介绍

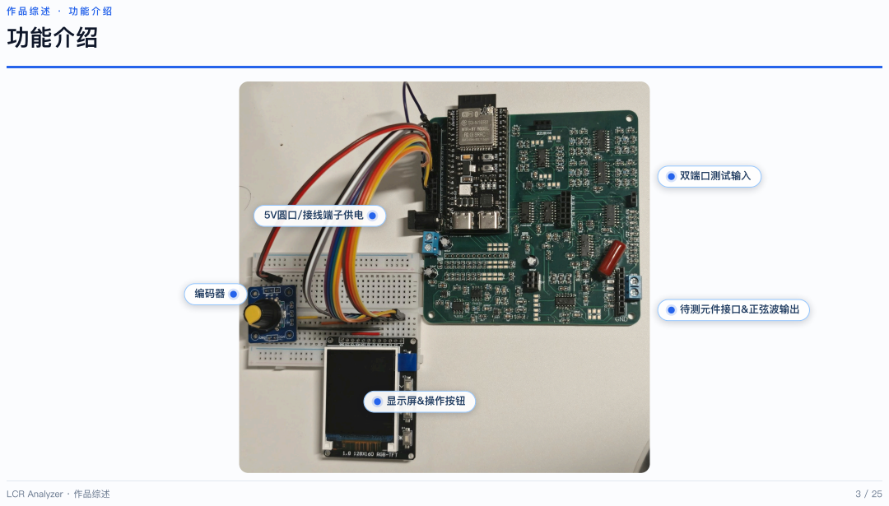
[picture p52: page 3]
LCR Analyzer · 作品综述; 双端口测试输入; 待测元件接口&正弦波输出; 5V圆口/接线端子供电; 显示屏&操作按钮; 编码器

# 功能介绍

## 操作流程

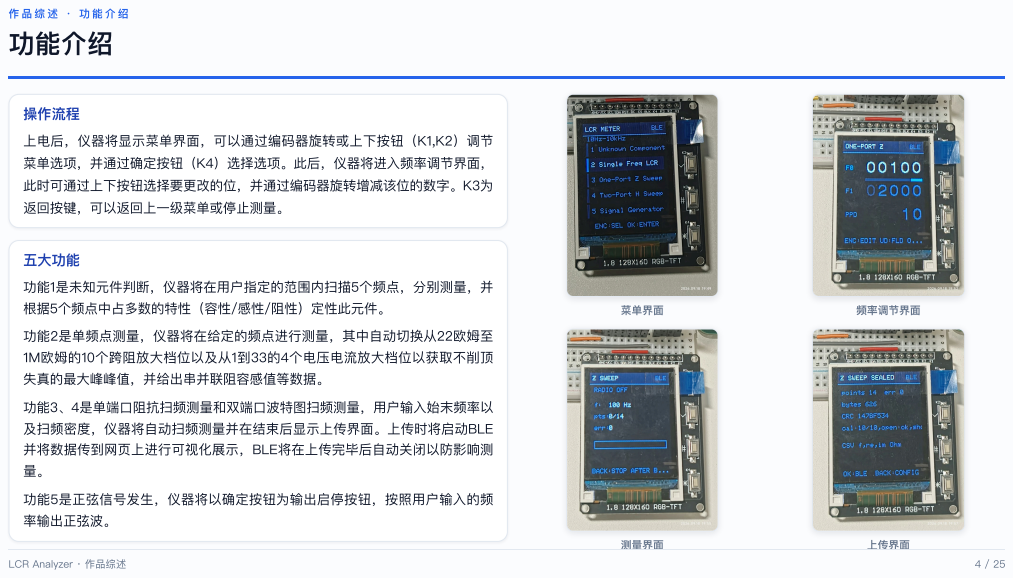
[picture p53: page 4]
五大功能; 功能2是单频点测量，仪器将在给定的频点进行测量，其中自动切换从22欧姆至; 1M欧姆的10个跨阻放大档位以及从1到33的4个电压电流放大档位以获取不削顶; 失真的最大峰峰值，并给出串并联阻容感值等数据。; 功能5是正弦信号发生，仪器将以确定按钮为输出启停按钮，按照用户输入的频; 率输出正弦波。; 菜单界面; 频率调节界面; 测量界面; 上传界面; LCR Analyzer · 作品综述

上电后，仪器将显示菜单界面，可以通过编码器旋转或上下按钮（K1,K2）调节
菜单选项，并通过确定按钮（K4）选择选项。此后，仪器将进入频率调节界面，
此时可通过上下按钮选择要更改的位，并通过编码器旋转增减该位的数字。K3为
返回按键，可以返回上一级菜单或停止测量。

功能1是未知元件判断，仪器将在用户指定的范围内扫描5个频点，分别测量，并
根据5个频点中占多数的特性（容性/感性/阻性）定性此元件。

功能3、4是单端口阻抗扫频测量和双端口波特图扫频测量，用户输入始末频率以
及扫频密度，仪器将自动扫频测量并在结束后显示上传界面。上传时将启动BLE
并将数据传到网页上进行可视化展示，BLE将在上传完毕后自动关闭以防影响测

L C R A N A L Y Z E R · H A R D W A R E

# 硬件部分

# 总体方案 · 信号链设计 · 实测数据

## 硬件总体方案框图 · 实测数据（R / C / L / 电容容量-频率特性 / 波特图）

LCR Analyzer · 硬件部分 | 5 / 25

硬 件 部 分 · 总 体 方 案

# 硬件总体方案框图[20]

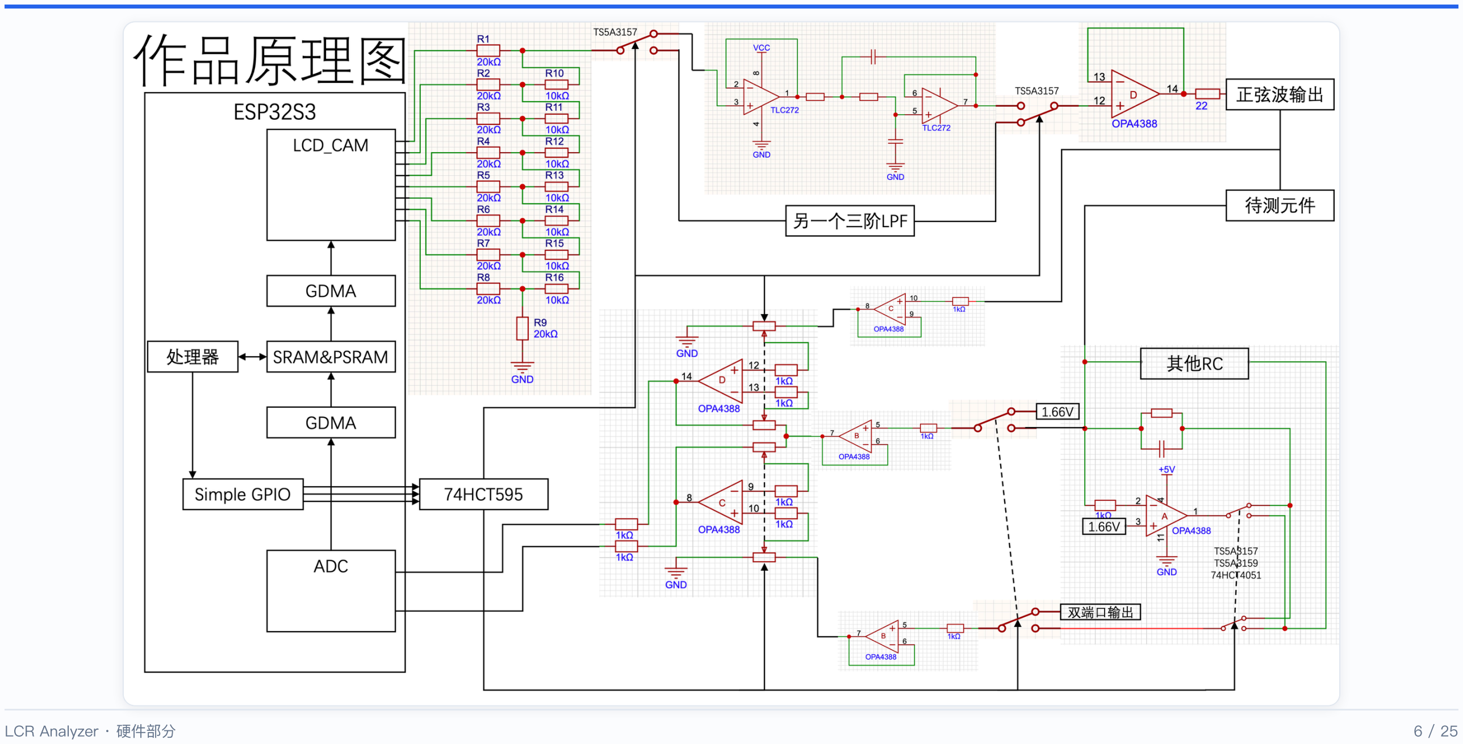
[picture p54: figure]
LCR Analyzer · 硬件部分

# 实测数据-R

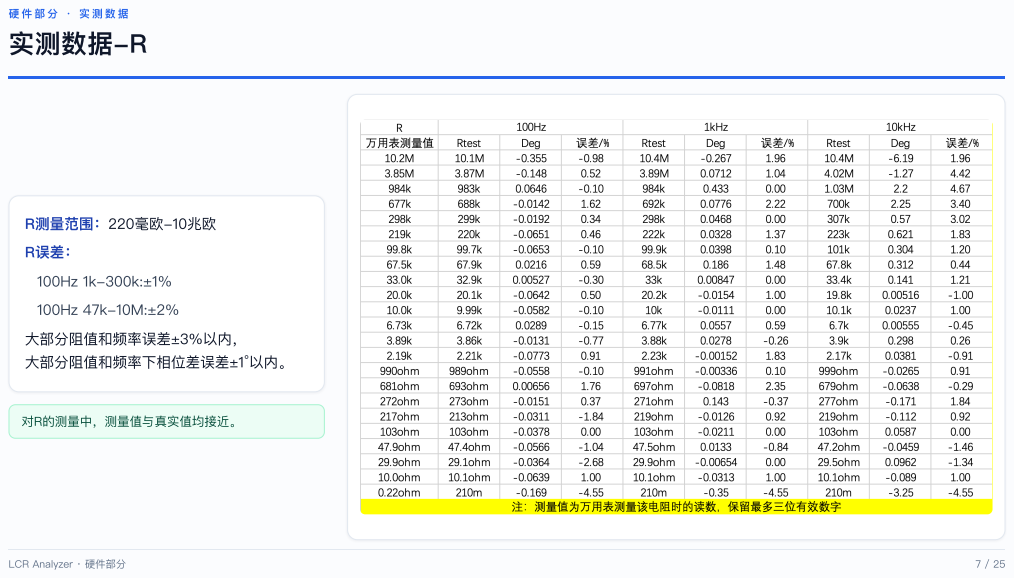
[picture p55: page 7]
R测量范围：220毫欧-10兆欧; R误差：; 大部分阻值和频率误差±3%以内，; 大部分阻值和频率下相位差误差±1°以内。; 对R的测量中，测量值与真实值均接近。; LCR Analyzer · 硬件部分

实
测

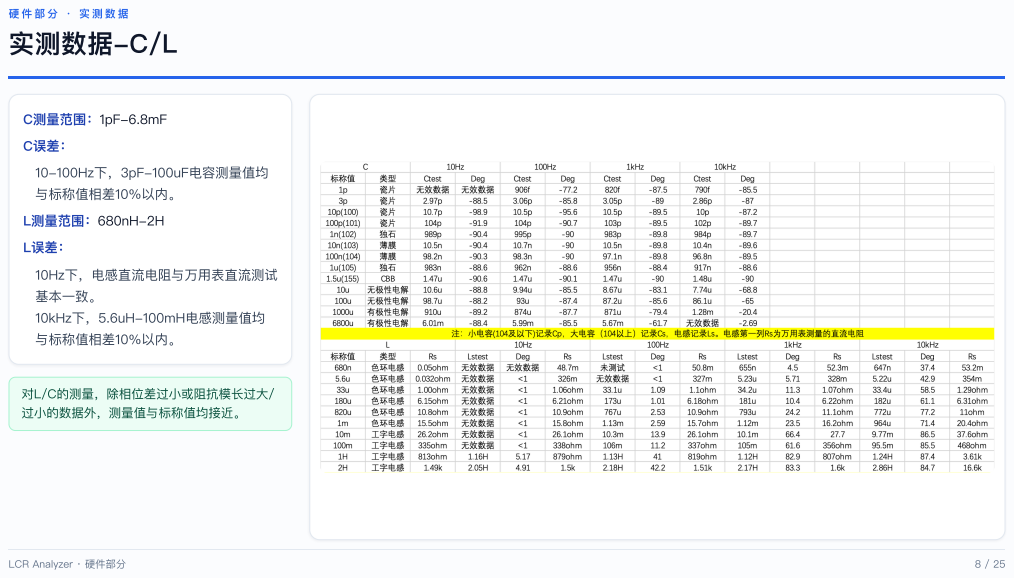
[picture p56: page 8]
阻与万; 直流测; 的数据; aly

# 实测数据-电容容量随频率变化

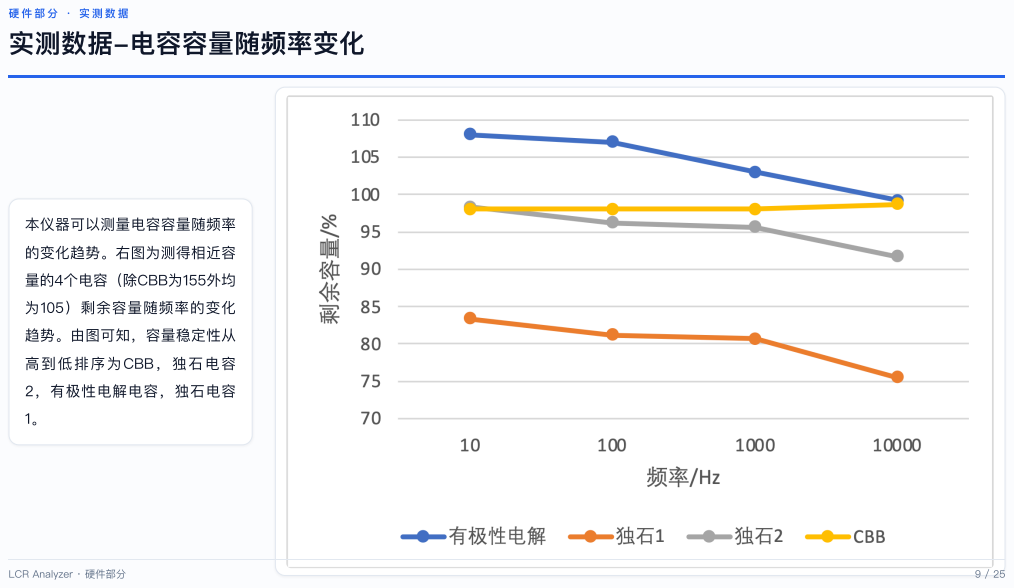
[picture p57: page 9]
本仪器可以测量电容容量随频率; 的变化趋势。右图为测得相近容; 量的4个电容（除CBB为155外均; 为105）剩余容量随频率的变化; 高到低排序为CBB，独石电容; 2，有极性电解电容，独石电容; LCR Analyzer · 硬件部分

趋势。由图可知，容量稳定性从

# 正弦输出

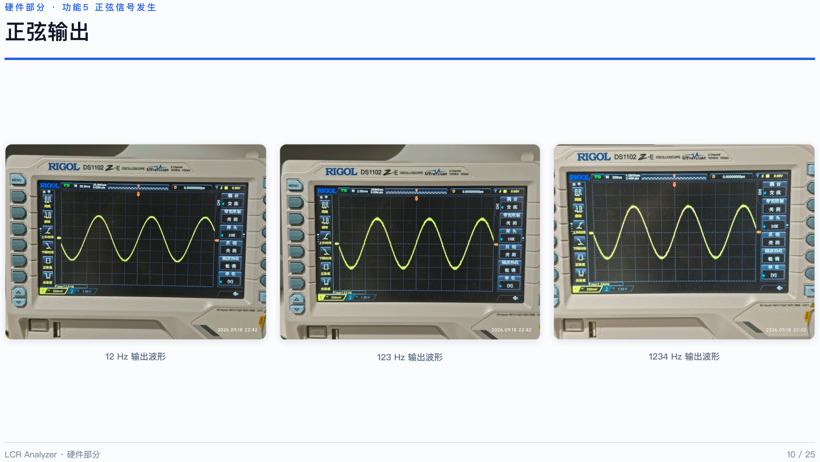
[picture p58: page 10]

硬 件 部 分 · 功 能 5 正 弦 信 号 发 生

12 Hz 输出波形 | 123 Hz 输出波形 | 1234 Hz 输出波形
LCR Analyzer · 硬件部分 | 10 / 25

硬 件 部 分 · 实 测 数 据

# 实测数据-波特图测量

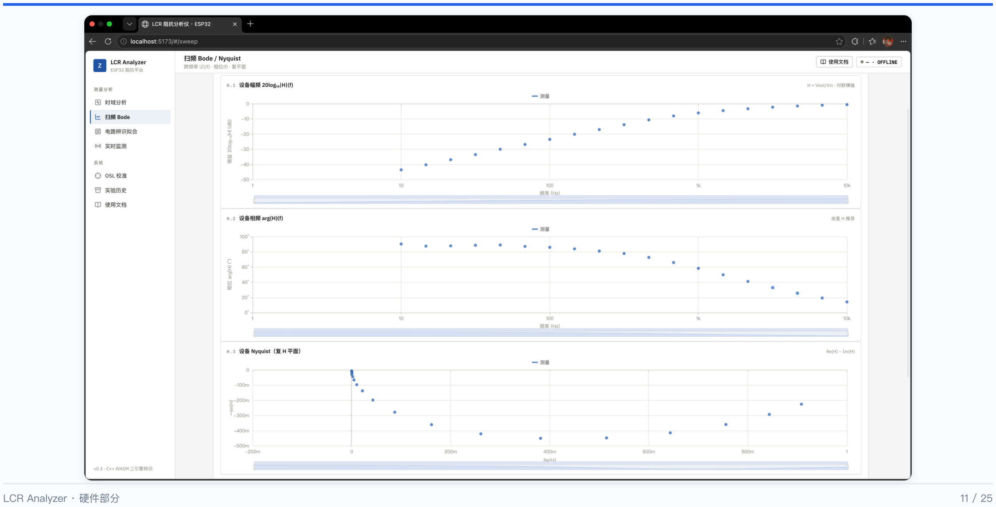
[picture p59: figure]
LCR Analyzer · 硬件部分

L C R A N A L Y Z E R · S O F T W A R E / A L G O R I T H M T H E O R Y

# LCR 阻抗测量与电路辨识

# 软件部分 · Try1–Try3：统一前向模型、图搜索与参数优化

## 基于 AlgorithmLcr v4.1.2 共享 C++/Eigen 核心（原生 CLI 与浏览器 WASM 同源）

## 所有拟合图与数字均来自本仓库对四组真实测量数据（10 Hz–10 kHz）的实际运行

# 给定扫频测量 Z(fk)，寻找电路图 G 与参数 θ，使 Zcalc(fk) = b Y (f ) b 逼近测量

LCR Analyzer · Try1–Try3 算法理论 | 12 / 25

# 共用核 I：问题定义与三档先验

## 测量数据与可观测量

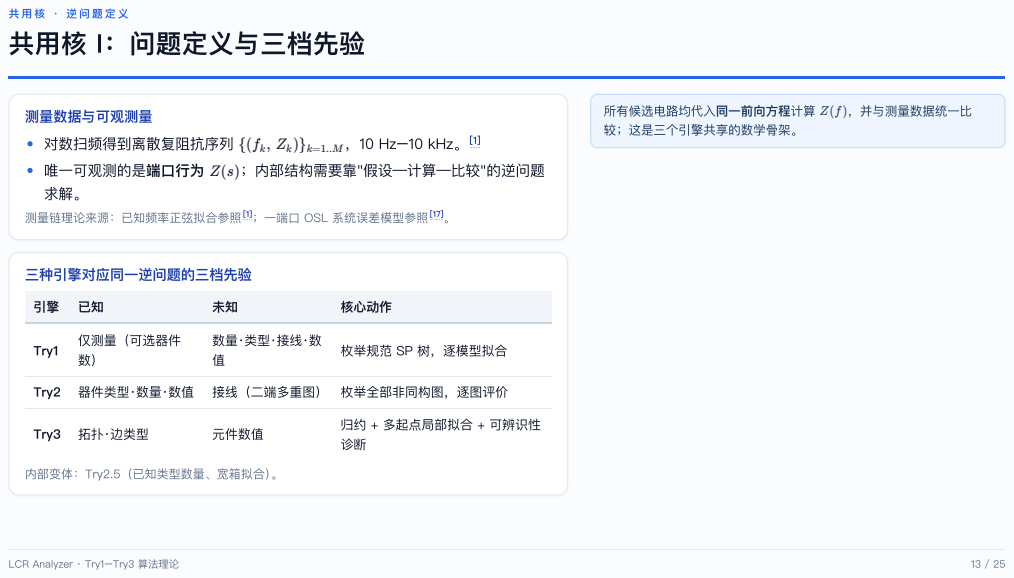
[picture p60: page 13]
对数扫频得到离散复阻抗序列; ，10 Hz–10 kHz。[1]; 唯一可观测的是端口行为; ；内部结构需要靠"假设—计算—比较"的逆问题; 三种引擎对应同一逆问题的三档先验; 核心动作; Try1; 仅测量（可选器件; Try2; 器件类型·数量·数值; 接线（二端多重图） 枚举全部非同构图，逐图评价; Try3; 拓扑·边类型; 元件数值; 所有候选电路均代入同一前向方程计算; ，并与测量数据统一; 较；这是三个引擎共享的数学骨架。

测量链理论来源：已知频率正弦拟合参照[1]；一端口 OSL 系统误差模型参照[17]。

枚举规范 SP 树，逐模型拟合

归约 + 多起点局部拟合 + 可辨识性

内部变体：Try2.5（已知类型数量、宽箱拟合）。

# 共用核 II：电路图模型与元件表示

## 图模型定义

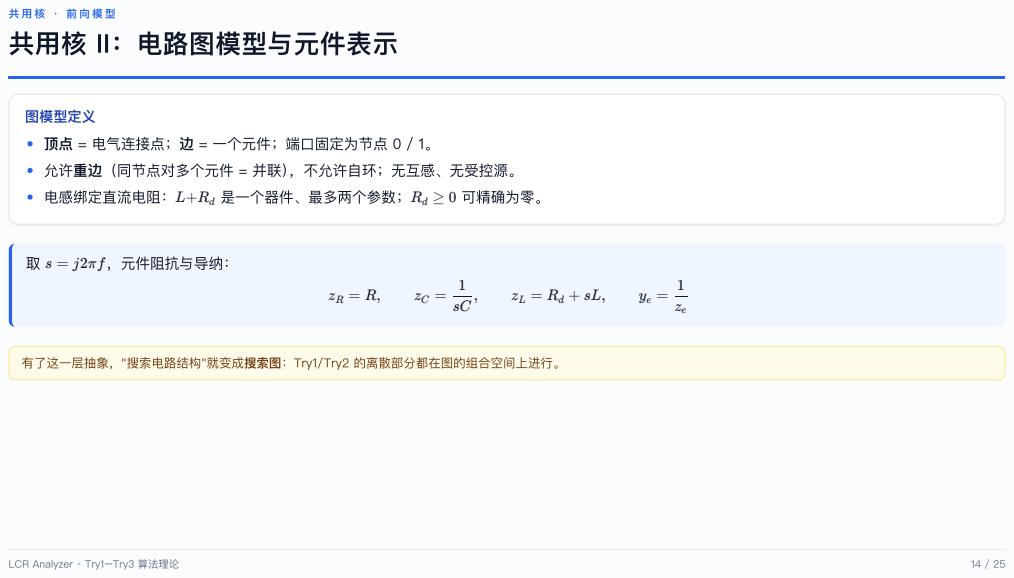
[picture p61: page 14]
电感绑定直流电阻：; 是一个器件、最多两个参数；; 可精确为零。; ，元件阻抗与导纳：

顶点 = 电气连接点；边 = 一个元件；端口固定为节点 0 / 1。

允许重边（同节点对多个元件 = 并联），不允许自环；无互感、无受控源。

有了这一层抽象，"搜索电路结构"就变成搜索图：Try1/Try2 的离散部分都在图的组合空间上进行。

# 共用核 III：节点导纳矩阵装配

## 支路导纳 Stamp（导纳 ，端点 ）

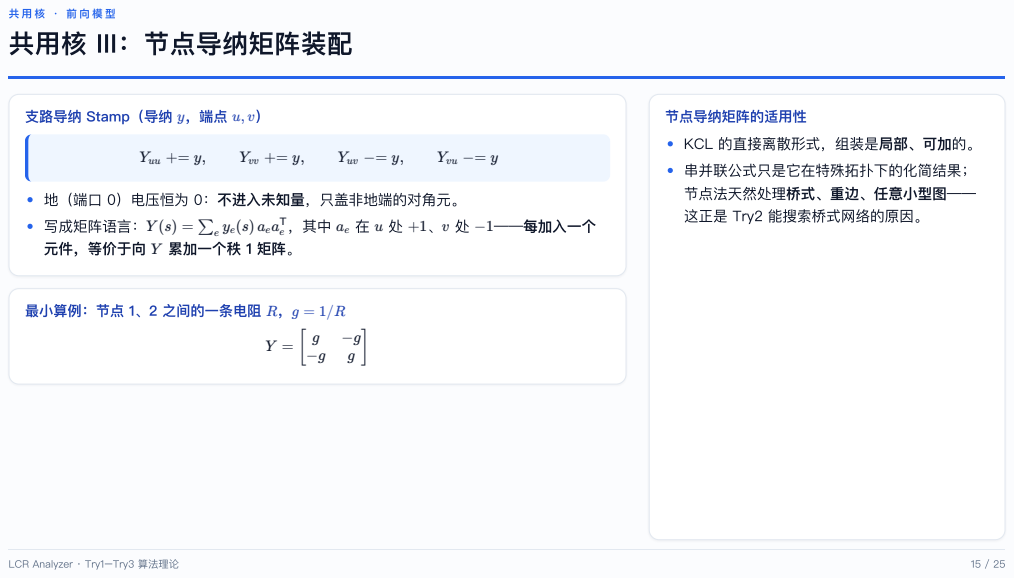
[picture p62: page 15]
写成矩阵语言：; ——每加入一个; 元件，等价于向; 累加一个秩 1 矩阵。; 最小算例：节点 1、2 之间的一条电阻; 节点导纳矩阵的适用性; Yuu += y,; Yvv += y,; Yuv −= y,; Yvu −= y

KCL 的直接离散形式，组装是局部、可加的。

串并联公式只是它在特殊拓扑下的化简结果；
节点法天然处理桥式、重边、任意小型图——
这正是 Try2 能搜索桥式网络的原因。

地（端口 0）电压恒为 0：不进入未知量，只盖非地端的对角元。

# 共用核 IV：端口阻抗前向求解

## 四步推导（单位电流激励）[2]

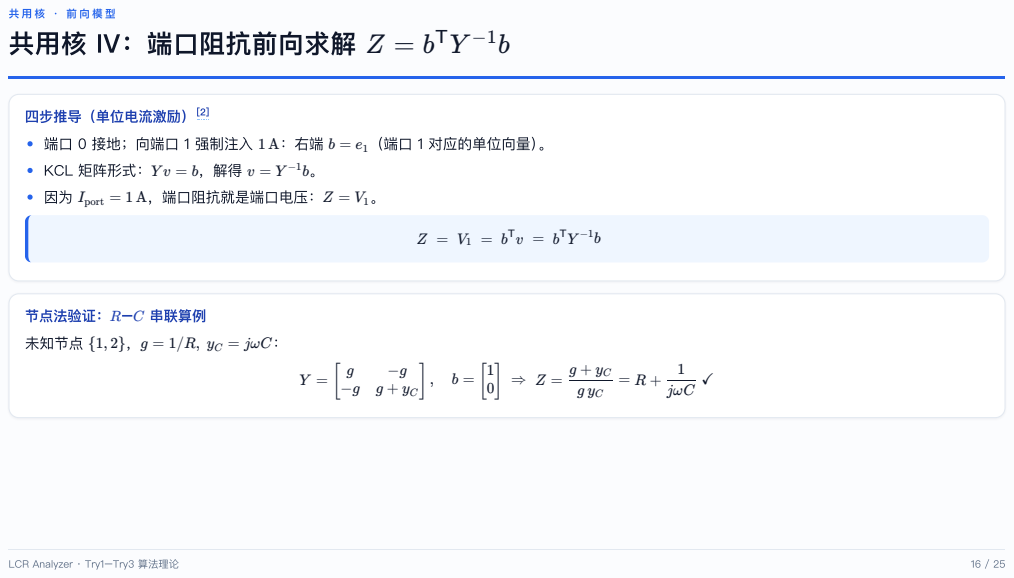
[picture p63: page 16]
端口 0 接地；向端口 1 强制注入; （端口 1 对应的单位向量）。; KCL 矩阵形式：; ，端口阻抗就是端口电压：; 节点法验证： –; 串联算例; 未知节点; Iport = 1 A; R C {1, 2} g = 1/R, yC = jωC; jωC

# 共用核 V：拟合误差与模型选择指标

## 白化相对残差（默认噪声模型）

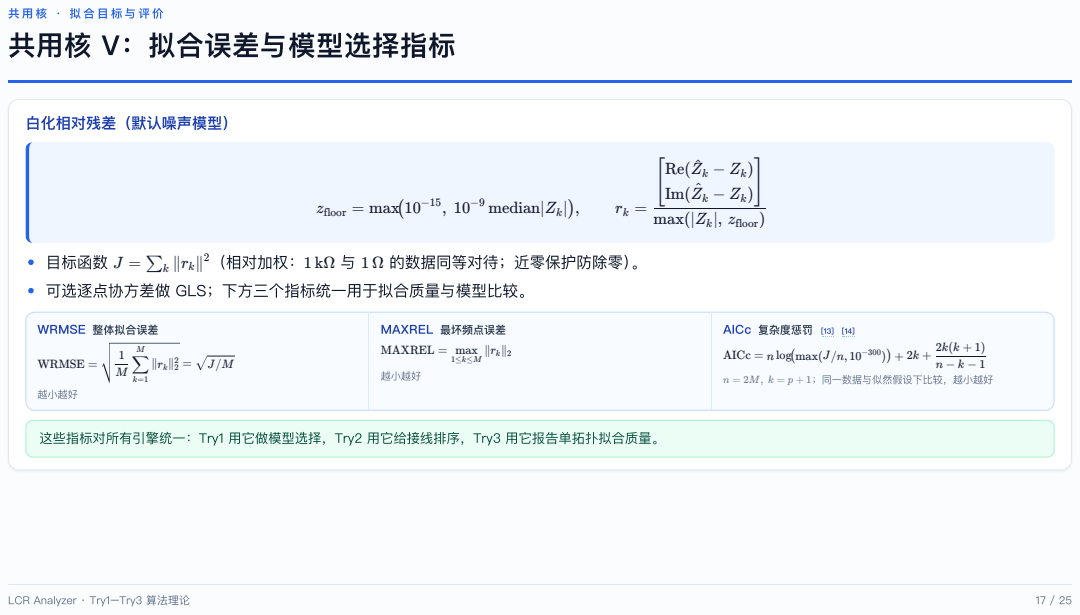
[picture p64: page 17]
目标函数; （相对加权：; 的数据同等对待；近零保护防除零）。; 可选逐点协方差做 GLS；下方三个指标统一; 用于拟合质量与模型比较。; WRMSE 整体拟合误差; 越小越好; MAXREL 最坏频点误差; AICc 复杂度惩罚 [13] [14]; ；同一数据与似然假设下比较，越小越好; zfloor = max(10 , 10 median∣Z ∣),; max(∣Zk∣, zfloor); WRMSE =; MAXREL =; max; AICc = n log(max(J/n, 10

这些指标对所有引擎统一：Try1 用它做模型选择，Try2 用它给接线排序，Try3 用它报告单拓扑拟合质量。

# Try3（I）：元件参数计算——参数化、初值与多起点

## 优化坐标：数量级差异的尺度化处理

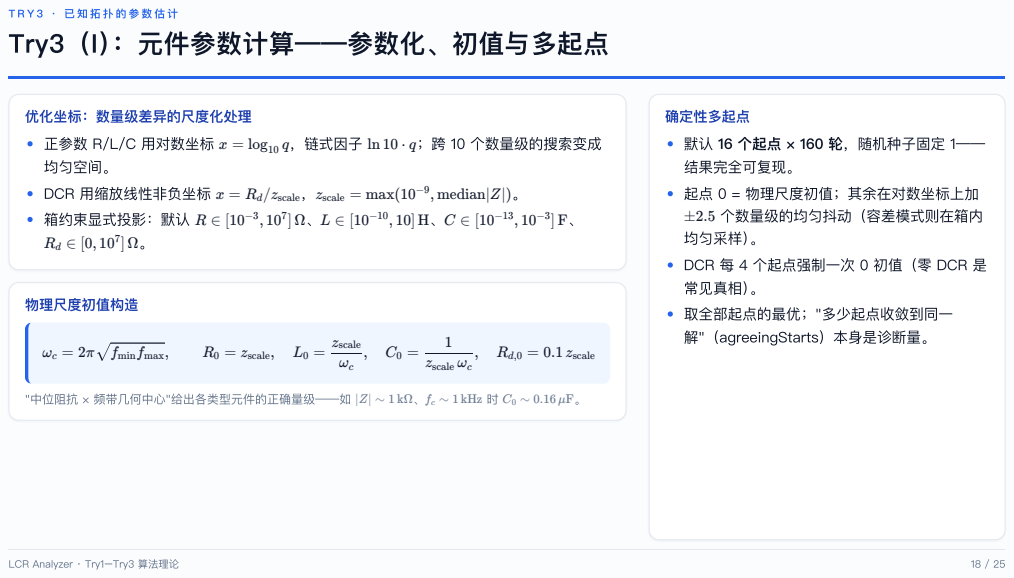
[picture p65: page 18]
正参数 R/L/C 用对数坐标; ，链式因子; ；跨 10 个数量级的搜索变成; 均匀空间。; DCR 用缩放线性非负坐标; 箱约束显式投影：默认; 物理尺度初值构造; "中位阻抗 × 频带几何中心"给出各类型元件的正确量级——如; 确定性多起点; x = log q 10; x = Rd/zscale; zscale = max(10 , median∣Z∣); ωc = 2π fminfmax,; R0 = zscale, L0 =; zscale; zscale ωc; 0.1 zscale; ∣Z∣ ∼ 1 kΩ fc ∼ 1 kHz

默认 16 个起点 × 160 轮，随机种子固定 1——
结果完全可复现。

起点 0 = 物理尺度初值；其余在对数坐标上加
个数量级的均匀抖动（容差模式则在箱内
均匀采样）。

DCR 每 4 个起点强制一次 0 初值（零 DCR 是
常见真相）。
取全部起点的最优；"多少起点收敛到同一
解"（agreeingStarts）本身是诊断量。

# Try3（II）：元件参数计算——解析灵敏度与 Levenberg–Marquardt

解析 Jacobian：对 | 微分（普通转置，非共轭）

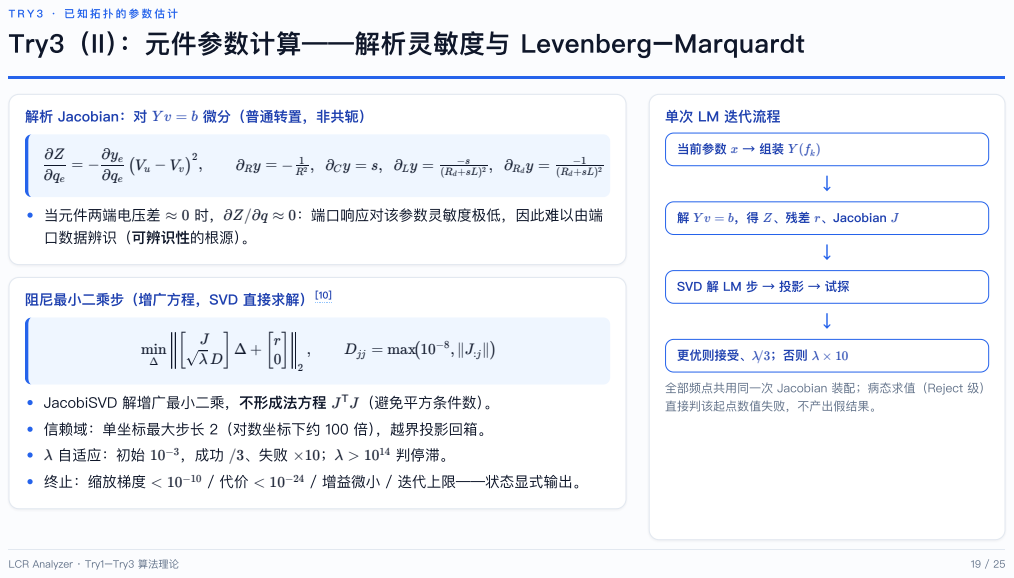
[picture p66: page 19]
当元件两端电压差; ：端口响应对该参数灵敏度极低，因此难以由端; 口数据辨识（可辨识性的根源）。; JacobiSVD 解增广最小二乘，不形成法方程; （避免平方条件数）。; 自适应：初始; 判停滞。; 终止：缩放梯度; / 增益微小 / 迭代上限——状态显式输出。; 当前参数; 、残差 、Jacobian; 更优则接受、; min [; max(10 , ∥J ∥)

单次 LM 迭代流程

SVD 解 LM 步 → 投影 → 试探

阻尼最小二乘步（增广方程，SVD 直接求解）[10]

全部频点共用同一次 Jacobian 装配；病态求值（Reject 级）
直接判该起点数值失败，不产出假结果。

信赖域：单坐标最大步长 2（对数坐标下约 100 倍），越界投影回箱。

# Try2：拓扑搜索——完整枚举与候选评价

## 节点数范围

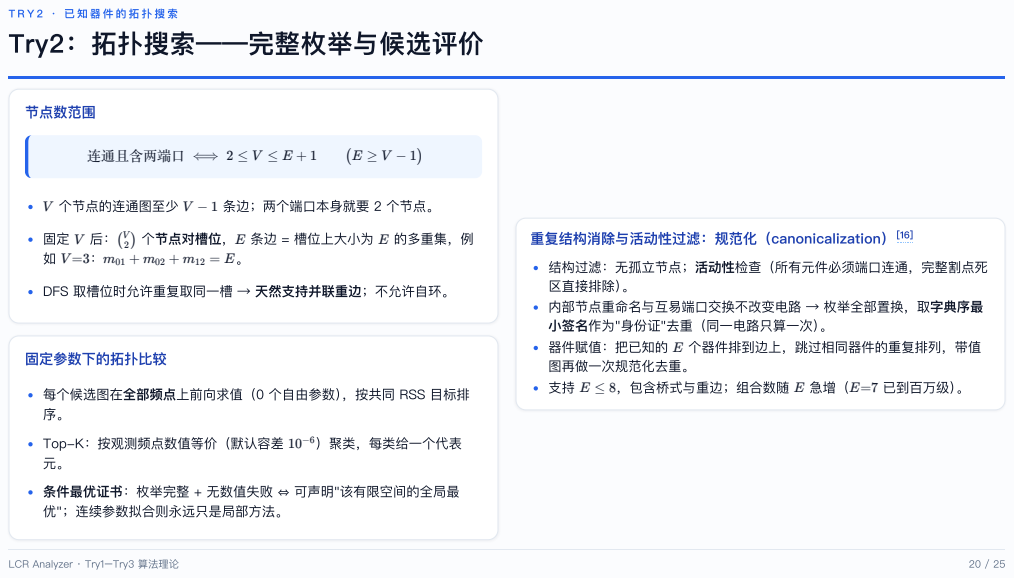
[picture p67: page 20]
个节点的连通图至少; 条边；两个端口本身就要 2 个节点。; 个节点对槽位， 条边 = 槽位上大小为; 的多重集，例; 固定参数下的拓扑比较; Top-K：按观测频点数值等价（默认容差; ）聚类，每类给一个代表; 器件赋值：把已知的; 个器件排到边上，跳过相同器件的重复排列，带值; ，包含桥式与重边；组合数随; 已到百万级）。; 连通且含两端口 ⟺ 2 ≤ V ≤ E + 1

重复结构消除与活动性过滤：规范化（canonicalization）[16]

结构过滤：无孤立节点；活动性检查（所有元件必须端口连通，完整割点死
区直接排除）。
内部节点重命名与互易端口交换不改变电路 → 枚举全部置换，取字典序最
小签名作为"身份证"去重（同一电路只算一次）。
图再做一次规范化去重。

DFS 取槽位时允许重复取同一槽 → 天然支持并联重边；不允许自环。

每个候选图在全部频点上前向求值（0 个自由参数），按共同 RSS 目标排

条件最优证书：枚举完整 + 无数值失败 ⇔ 可声明"该有限空间的全局最
优"；连续参数拟合则永远只是局部方法。

# Try1：结构发现——规范串并联（SP）树枚举

## 假设空间：SP 表达式树[18] [19]

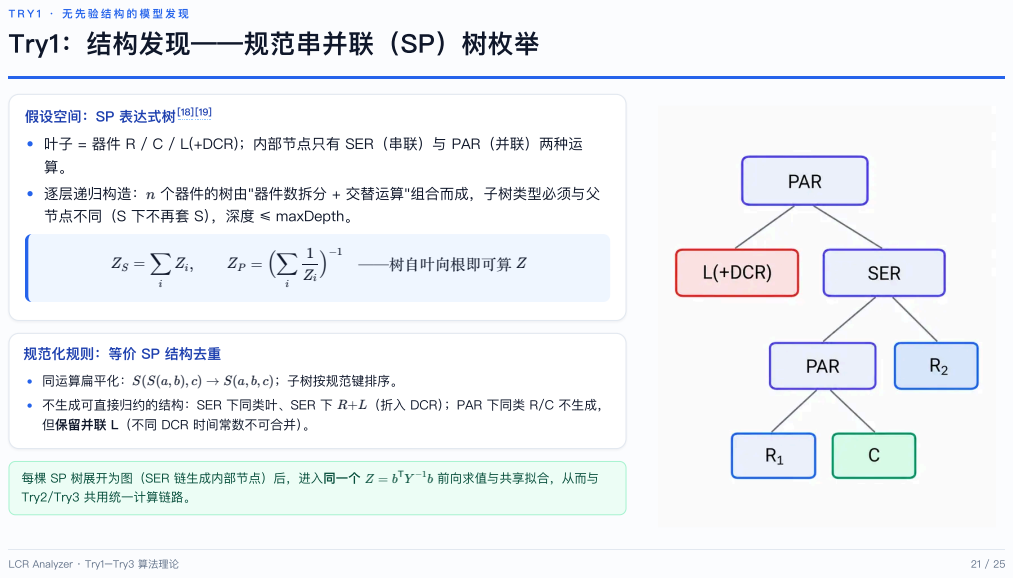
[picture p68: page 21]
同运算扁平化：; ；子树按规范键排序。; 不生成可直接归约的结构：SER 下同类叶、SER 下; （折入 DCR）；PAR 下同类 R/C 不生成，; 每棵 SP 树展开为图（SER 链生成内部节点）后，进入同一个; 前向求值与共享拟合，从而与; Try2/Try3 共用统一计算链路。; ) ——树自叶向根即可算 Z

叶子 = 器件 R / C / L(+DCR)；内部节点只有 SER（串联）与 PAR（并联）两种运

逐层递归构造： 个器件的树由"器件数拆分 + 交替运算"组合而成，子树类型必须与父
节点不同（S 下不再套 S），深度 ≤ maxDepth。

规范化规则：等价 SP 结构去重

但保留并联 L（不同 DCR 时间常数不可合并）。

# Try1 拟合样例：未知结构搜索结果

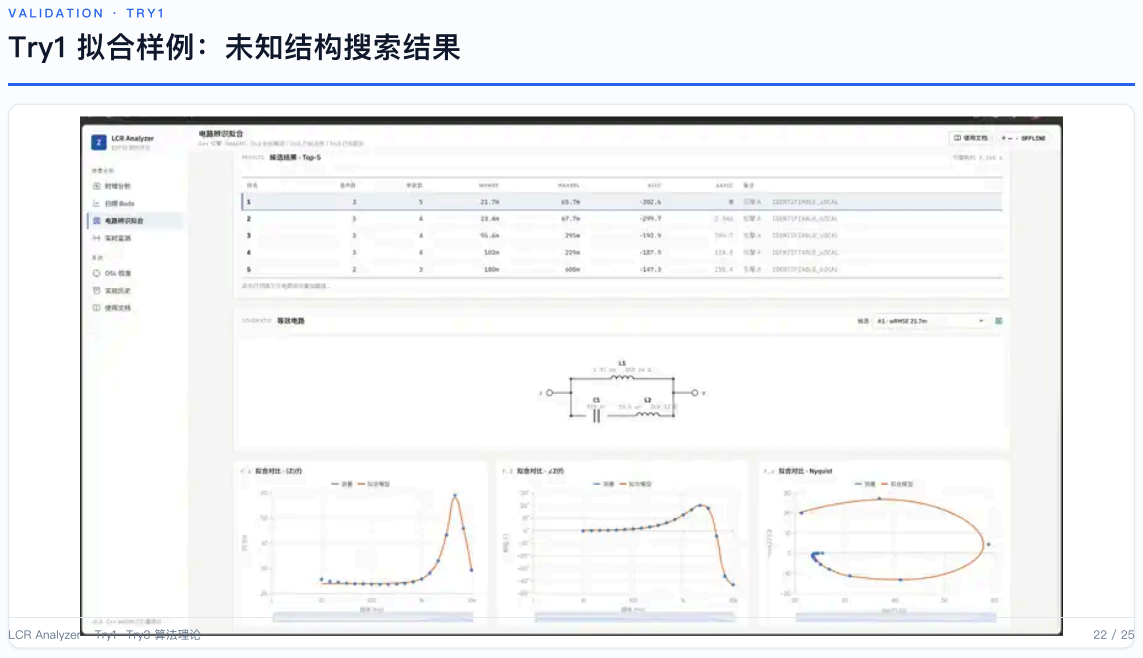
[picture p69: page 22]

# Try3 拟合样例：已知拓扑的参数拟合

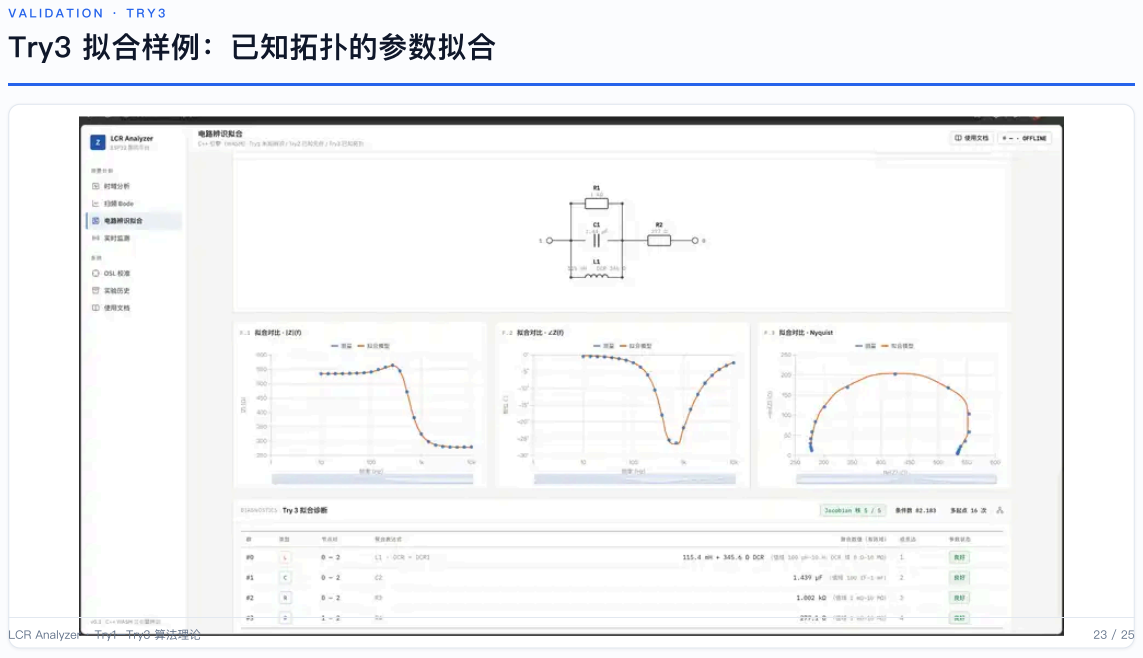
[picture p70: page 23]

# 总结：共用核与 Try1–Try3

## 统一算法管线（三个引擎共享同一数学实现）

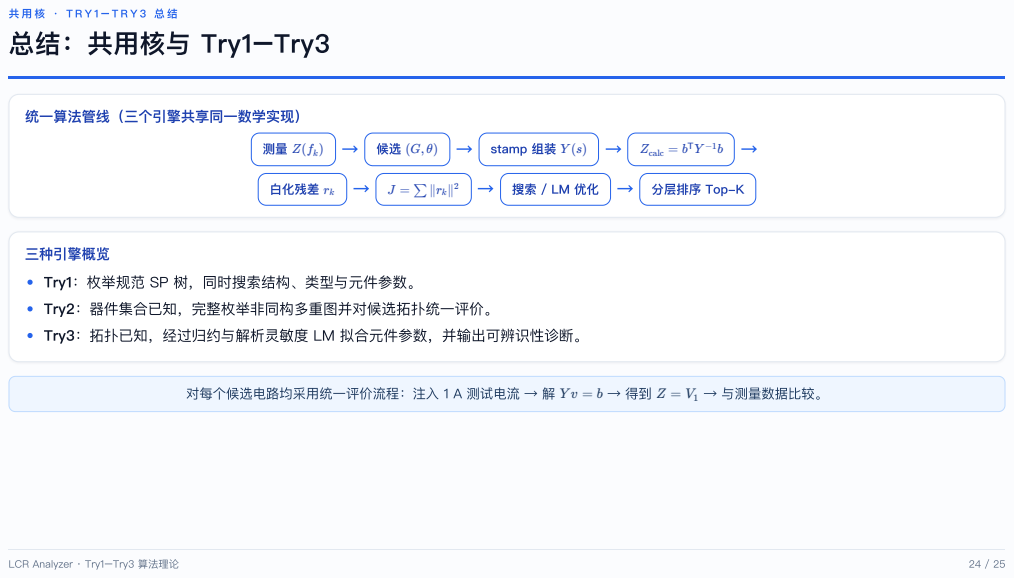
[picture p71: page 24]
→ stamp 组装; 白化残差; → 分层排序 Top-K; 三种引擎概览; Try2：器件集合已知，完整枚举非同构多重图并对候选拓扑统一评价。; 对每个候选电路均采用统一评价流程：注入 1 A 测试电流 → 解; → 与测量数据比较。; Zcalc = b Y b

Try1：枚举规范 SP 树，同时搜索结构、类型与元件参数。

Try3：拓扑已知，经过归约与解析灵敏度 LM 拟合元件参数，并输出可辨识性诊断。

R E F E R E N C E S

# 参考文献与技术标准

1. IEEE Std 1057-2017, IEEE Standard for Digitizing Waveform Recorders, Annex A: three-parameter known-frequency sine fitting.
2. C.-W. Ho, A. E. Ruehli, P. A. Brennan, “The modified nodal approach to network analysis,” IEEE Trans. Circuits and Systems, 22(6), 504–509, 1975. doi:10.1109/TCS.1975.1084079 (https://doi.org/10.1109/TCS.1975.1084079)
3. O. Brune, “Synthesis of a Finite Two-terminal Network whose Driving-point Impedance is a Prescribed Function of Frequency,” J. Mathematics and Physics, 10, 191–236, 1931. doi:10.1002/sapm1931101191 (https://doi.org/10.1002/sapm1931101191)
4. R. J. Duffin, R. Bott, “Impedance synthesis without use of transformers,” J. Applied Physics, 20(8), 816, 1949. doi:10.1063/1.1698532 (https://doi.org/10.1063/1.1698532)
5. R. M. Foster, “A Reactance Theorem,” Bell System Technical Journal, 3, 259–267, 1924.
6. W. Cauer, classical works on realization of prescribed frequency-dependent impedances and ladder synthesis, 1926–1927; see also Brune [3].
7. S. Chaiken, “A Combinatorial Proof of the All Minors Matrix Tree Theorem,” SIAM J. Algebraic Discrete Methods, 3(3), 319–329, 1982. doi:10.1137/0603033 (https://doi.org/10.1137/0603033)
8. H. Whitney, “2-Isomorphic Graphs,” American Journal of Mathematics, 55(1), 245–254, 1933. doi:10.2307/2371127 (https://doi.org/10.2307/2371127)
9. B. Gustavsen, A. Semlyen, “Rational approximation of frequency domain responses by vector fitting,” IEEE Trans. Power Delivery, 14(3), 1052–1061, 1999. doi:10.1109/61.772353 (https://doi.org/10.1109/61.772353)
10. D. W. Marquardt, “An Algorithm for Least-Squares Estimation of Nonlinear Parameters,” J. Society for Industrial and Applied Mathematics, 11(2), 431–441, 1963. doi:10.1137/0111030 (https://doi.org/10.1137/0111030)
11. T. J. Rothenberg, “Identification in Parametric Models,” Econometrica, 39(3), 577–591, 1971. doi:10.2307/1913267 (https://doi.org/10.2307/1913267)
12. L. Ljung, T. Glad, “On global identifiability for arbitrary model parametrizations,” Automatica, 30(2), 265–276, 1994. doi:10.1016/0005-1098(94)90029-9 (https://doi.org/10.1016/0005-1098(94)90029-9)
13. H. Akaike, “A new look at the statistical model identification,” IEEE Trans. Automatic Control, 19(6), 716–723, 1974. doi:10.1109/TAC.1974.1100705 (https://doi.org/10.1109/TAC.1974.1100705)
14. C. M. Hurvich, C.-L. Tsai, “Regression and time series model selection in small samples,” Biometrika, 76(2), 297–307, 1989. doi:10.1093/biomet/76.2.297 (https://doi.org/10.1093/biomet/76.2.297)
15. P. J. Huber, “Robust Estimation of a Location Parameter,” The Annals of Mathematical Statistics, 35(1), 73– 101, 1964. doi:10.1214/aoms/1177703732 (https://doi.org/10.1214/aoms/1177703732)
16. B. D. McKay, A. Piperno, “Practical graph isomorphism, II,” Journal of Symbolic Computation, 60, 94–112, 2014. doi:10.1016/j.jsc.2013.09.003 (https://doi.org/10.1016/j.jsc.2013.09.003)
17. Keysight Technologies, “1-Port Calibration (reflection test)” and “Measurement Errors”: one-port OSL calibration corrects directivity, source match, and reflection tracking errors. Manufacturer technical documentation.
18. R. J. Duffin, “Topology of Series-Parallel Networks,” Journal of Mathematical Analysis and Applications, 10(2), 303–318, 1965. doi:10.1016/0022-247X(65)90125-3 (https://doi.org/10.1016/0022-247X(65)90125-3)
19. X. He, Y. Yesha, “Parallel recognition and decomposition of two terminal series parallel graphs,” Information and Computation, 75(1), 15–38, 1987. doi:10.1016/0890-5401(87)90061-7 (https://doi.org/10.1016/0890-5401(87)90061-7)
20. bitluni (b.luni laboratories), ESP32-S3-VGA: open-source C++/Arduino library generating VGA video on ESP32-S3 via the LCD_CAM peripheral and parallel GPIO output into an external resistor-ladder DAC — the signal-generation technique adapted by this project for sine-wave synthesis. GitHub repository. github.com/bitluni/ESP32-S3-VGA
