180337/LCR-Analyzer-WebSite-ZXY/ino/LCR_UI/board_profile.h

// ============================================================================
// board_profile.h —— UI/控制外设引脚唯一出处（测量硬件不在此文件）
// ----------------------------------------------------------------------------
// 测量硬件全部由 DO_NOT_TOUCH 头文件定义；本 profile 只描述 TFT、按键、
// EC11 与 GPIO4 诊断开关。ST7735S 4-line serial 产品时钟固定 10 MHz。
// ============================================================================

#pragma once

#include <stdint.h>

#define PIN_UNUSED (-1)

// ---------------------------------------------------------------------------
// 按键有效电平（编译期可配置）
//   0：低电平按下，GPIO 使用内部上拉（默认；与现有实板接地按键一致）
//   1：高电平按下，GPIO 使用内部下拉
// 可在 Arduino/PlatformIO 编译参数中定义 -DLCR_BUTTON_ACTIVE_HIGH=1 覆盖默认值。
// 编码器 A/B 相仍固定使用 INPUT_PULLUP；本宏只影响 4 个功能按键/ENC_SW。
// ---------------------------------------------------------------------------
#ifndef LCR_BUTTON_ACTIVE_HIGH
#define LCR_BUTTON_ACTIVE_HIGH 0
#endif

#if (LCR_BUTTON_ACTIVE_HIGH != 0) && (LCR_BUTTON_ACTIVE_HIGH != 1)
#error "LCR_BUTTON_ACTIVE_HIGH must be 0 (active-low) or 1 (active-high)"
#endif

struct BoardProfile {
    int tftCs;
    int tftDc;
    int tftRst;
    int spiSck;
    int spiMosi;
    int spiMiso;
    uint32_t tftSpiHz;
    uint16_t tftWidth;
    uint16_t tftHeight;
    int16_t tftXOffset;
    int16_t tftYOffset;
    uint8_t tftRotation;
    bool tftInvert;

    int keyUp, keyDown, keyBack, keyOk;
    int encA, encB, encSw;

    // 与 DO_NOT_TOUCH_EXAMPLE 完全相同的诊断开关语义：INPUT_PULLUP，
    // HIGH（悬空/3.3V）= DNT 诊断打印开启，LOW（接 GND）= 关闭。
    int diagEnable;
};

extern const BoardProfile kBoard;
