180337/LCR-Analyzer-WebSite-ZXY/(commit log)

2026-09-13 DNT 硬件 v4：74HC595 位映射重排并新增频率选择输出（HC595_BIT_FSEL）
2026-09-14 Reduce ESP32 TFT refresh flicker
2026-09-15 Add configurable button active level
2026-09-15 Honor configurable button polarity
2026-09-15 Cover pico-scale engineering chart labels
2026-09-15 Add fixed-decimal Q/D formatter
    [ratio_format.h]
2026-09-15 Render Q and D as fixed-decimal rows
    [screen_single_point.cpp]
2026-09-16 Widen browser capacitor fit domain above 1 mF
2026-09-16 Cover large capacitor bounds in WASM smoke tests
2026-09-16 Document website capacitor fit bounds
2026-09-18 docs: remove colloquial graph assembly wording
2026-09-18 docs: remove circuit graph example figure
2026-09-18 docs: remove sample point-count wording
2026-09-18 docs: tighten Try2 canonicalization list spacing
2026-09-19 frontend: avoid backend probe in static mode
2026-09-22 update ino
    [硬设作品接线表（杜邦线连接）.xlsx]
